SKhatri1029/uwrt_electronics/Maelstrom Boards/Battery Balancer/BatteryBalancer.brd

## EAGLE design Maelstrom Boards/Battery Balancer/BatteryBalancer.brd (2019-02-17)

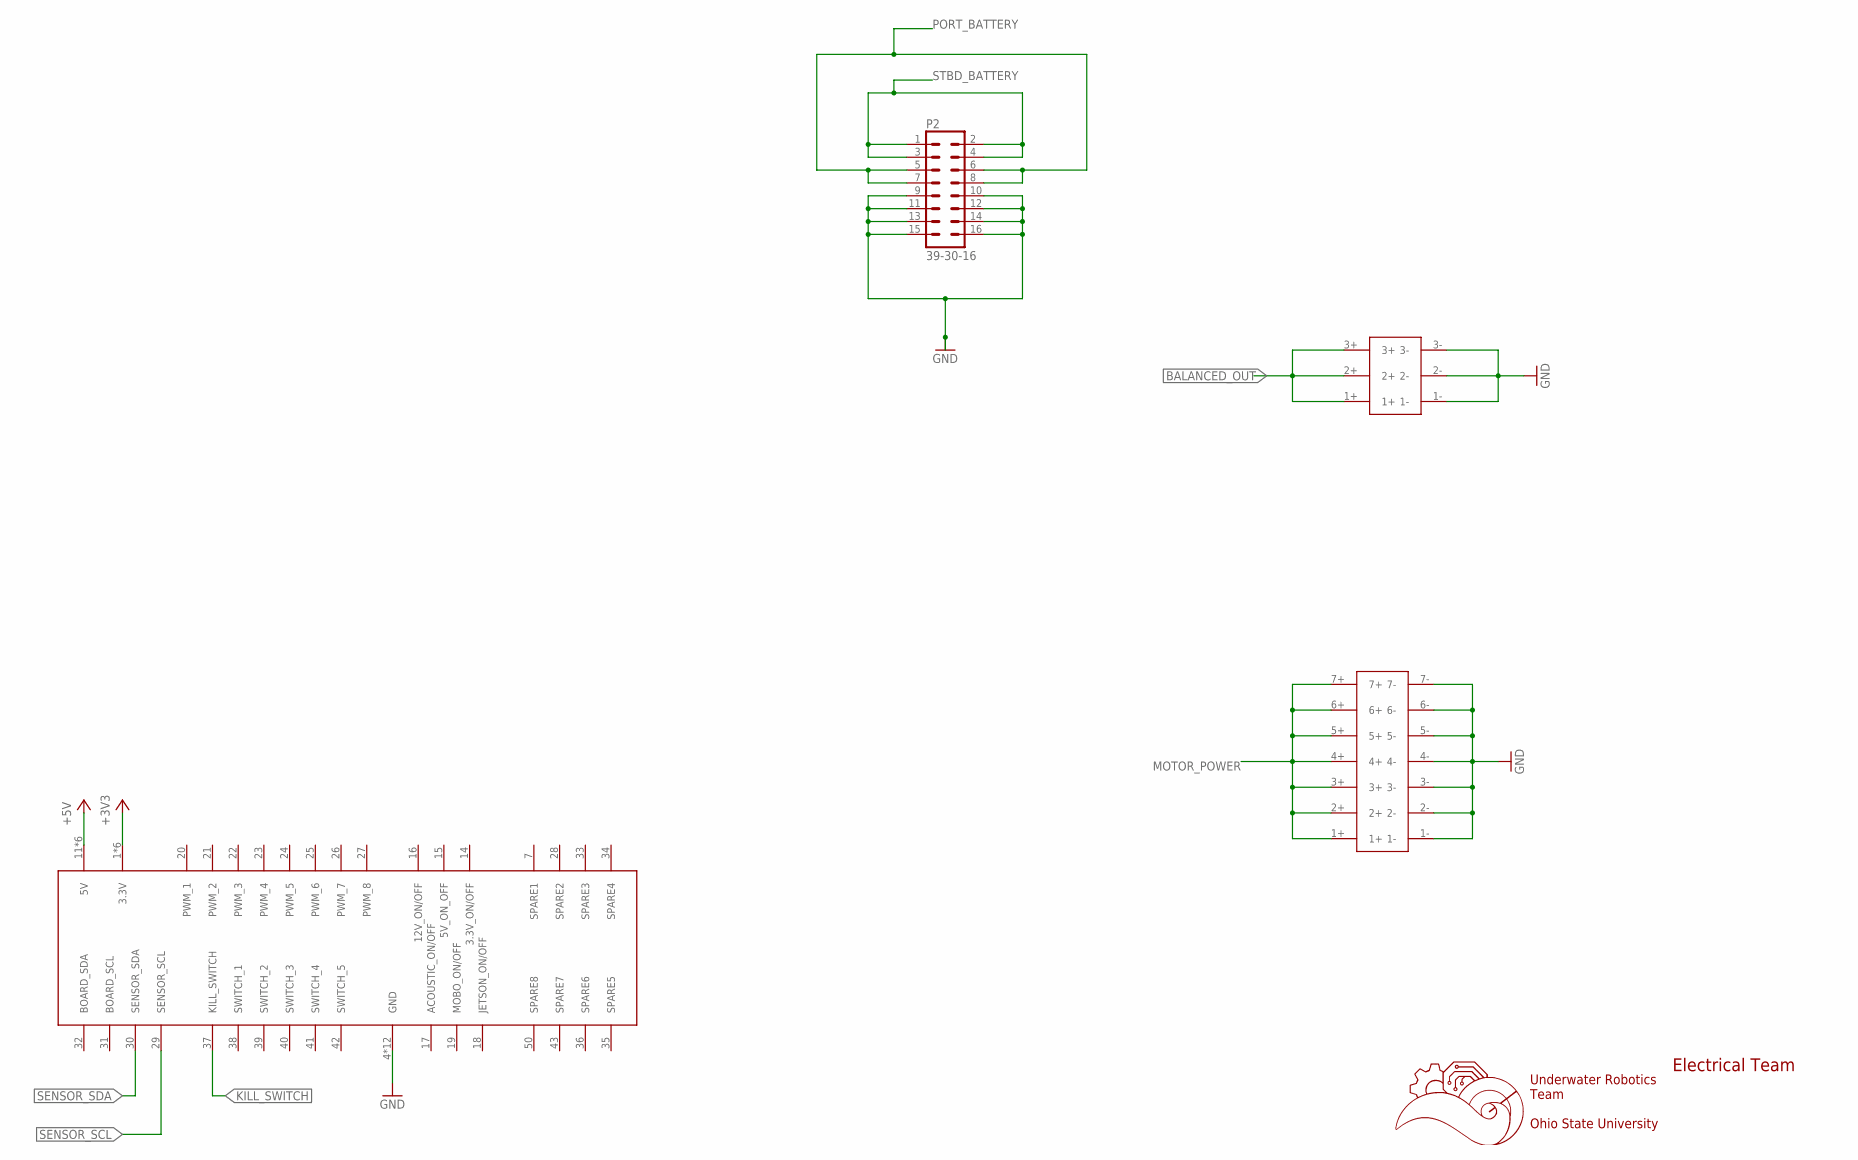
[picture p1: schematic BatteryBalancer.sch, sheet 1, Connectors]

Parts:
P2: 39-30-16; 39-30-?16?
U$1: 5530843-EDGE; 5530843-6-BOARDFINGERS
U$4: 14PIN-VERT; 14PIN_VERT
U$13: 6PIN-VERT; 6PIN_VERT

Connections:
+3V3: U$1.1 (3.3V), U$1.2 (3.3V), U$1.3 (3.3V), U$1.54 (3.3V), U$1.55 (3.3V), U$1.56 (3.3V); also elsewhere on the board
+5V: U$1.11 (5V), U$1.12 (5V), U$1.13 (5V), U$1.44 (5V), U$1.45 (5V), U$1.46 (5V)
BALANCED_OUT: U$13.1+, U$13.2+, U$13.3+; also elsewhere on the board
GND: P2.9, P2.10, P2.11, P2.12, P2.13, P2.14, P2.15, P2.16, U$1.4 (GND), U$1.5 (GND), U$1.6 (GND), U$1.8 (GND), U$1.9 (GND), U$1.10 (GND), U$1.47 (GND), U$1.48 (GND), U$1.49 (GND), U$1.51 (GND), U$1.52 (GND), U$1.53 (GND), U$4.1-, U$4.2-, U$4.3-, U$4.4-, U$4.5-, U$4.6-, U$4.7-, U$13.1-, U$13.2-, U$13.3-; also elsewhere on the board
KILL_SWITCH: U$1.37 (KILL_SWITCH); also elsewhere on the board
MOTOR_POWER: U$4.1+, U$4.2+, U$4.3+, U$4.4+, U$4.5+, U$4.6+, U$4.7+; also elsewhere on the board
PORT_BATTERY: P2.5, P2.6, P2.7, P2.8; also elsewhere on the board
SENSOR_SCL: U$1.29 (SENSOR_SCL); also elsewhere on the board
SENSOR_SDA: U$1.30 (SENSOR_SDA); also elsewhere on the board
STBD_BATTERY: P2.1, P2.2, P2.3, P2.4; also elsewhere on the board

Notes on the sheet:
Underwater Robotics Team Ohio State University
Electrical Team

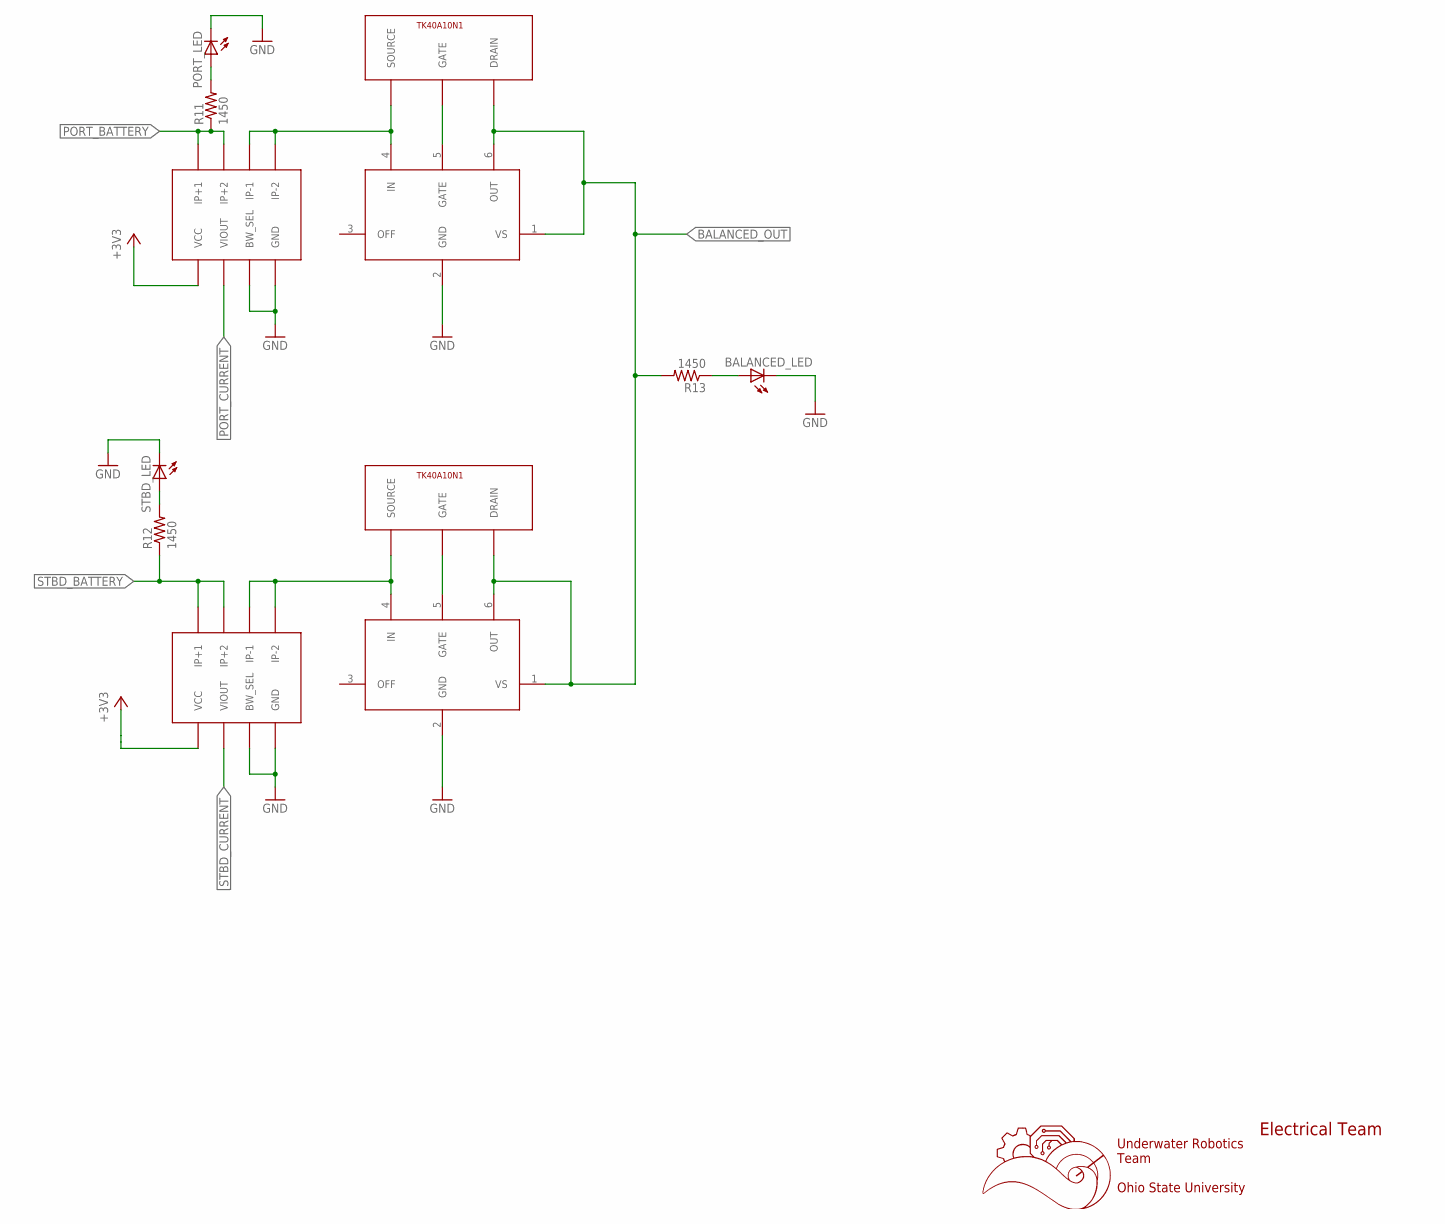
[picture p2: schematic BatteryBalancer.sch, sheet 2]

Parts:
BALANCED_LED: LEDCHIP-LED0603; CHIP-LED0603
PORT_LED: LEDCHIP-LED0603; CHIP-LED0603
R11, R12, R13: 1450; R0603
STBD_LED: LEDCHIP-LED0603; CHIP-LED0603
U$2, U$3: LM5050
U$5, U$15: IXFX64N60P3TK40A10N1; IXFX64N60P3
U$6, U$7: ACS722; SOIC-8

Connections:
+3V3: U$6.VCC, U$7.VCC; also elsewhere on the board
BALANCED_OUT: R13.2, U$2.1 (VS), U$2.6 (OUT), U$3.1 (VS), U$3.6 (OUT), U$5.DRAIN, U$15.DRAIN; also elsewhere on the board
GND: BALANCED_LED.C, PORT_LED.C, STBD_LED.C, U$2.2 (GND), U$3.2 (GND), U$6.BW_SEL, U$6.GND, U$7.BW_SEL, U$7.GND; also elsewhere on the board
unnamed: U$2.4 (IN), U$6.IP-1, U$6.IP-2, U$15.SOURCE
unnamed: U$2.5 (GATE), U$15.GATE
unnamed: U$3.5 (GATE), U$5.GATE
unnamed: PORT_LED.A, R11.2
unnamed: R12.2, STBD_LED.A
unnamed: BALANCED_LED.A, R13.1
PORT_BATTERY: R11.1, U$6.IP+1, U$6.IP+2; also elsewhere on the board
PORT_CURRENT: U$6.VIOUT; also elsewhere on the board
SOURCE: U$3.4 (IN), U$5.SOURCE, U$7.IP-1, U$7.IP-2
STBD_BATTERY: R12.1, U$7.IP+1, U$7.IP+2; also elsewhere on the board
STBD_CURRENT: U$7.VIOUT; also elsewhere on the board

Notes on the sheet:
Underwater Robotics Team Ohio State University
Electrical Team

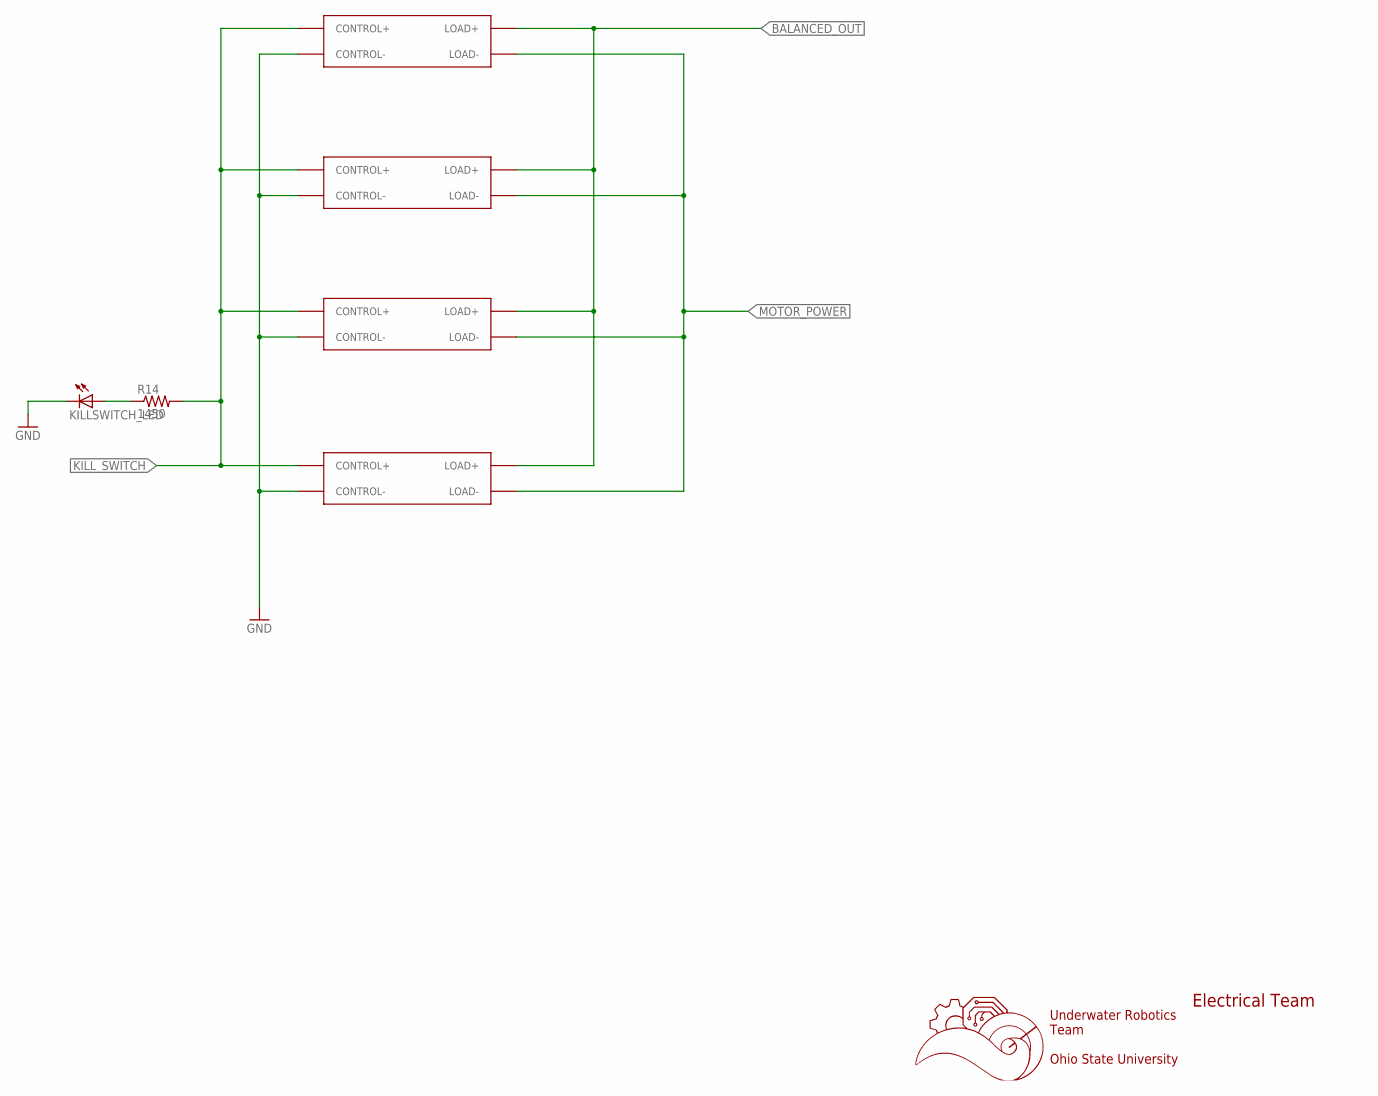
[picture p3: schematic BatteryBalancer.sch, sheet 3, Relays]

Parts:
KILLSWITCH_LED: LEDCHIP-LED0603; CHIP-LED0603
R14: 1450; R0603
U$8, U$9, U$10, U$11: CMX60D20

Connections:
BALANCED_OUT: U$8.LOAD+, U$9.LOAD+, U$10.LOAD+, U$11.LOAD+; also elsewhere on the board
GND: KILLSWITCH_LED.C, U$8.CONTROL-, U$9.CONTROL-, U$10.CONTROL-, U$11.CONTROL-; also elsewhere on the board
KILL_SWITCH: R14.2, U$8.CONTROL+, U$9.CONTROL+, U$10.CONTROL+, U$11.CONTROL+; also elsewhere on the board
MOTOR_POWER: U$8.LOAD-, U$9.LOAD-, U$10.LOAD-, U$11.LOAD-; also elsewhere on the board
unnamed: KILLSWITCH_LED.A, R14.1

Notes on the sheet:
Underwater Robotics Team Ohio State University
Electrical Team

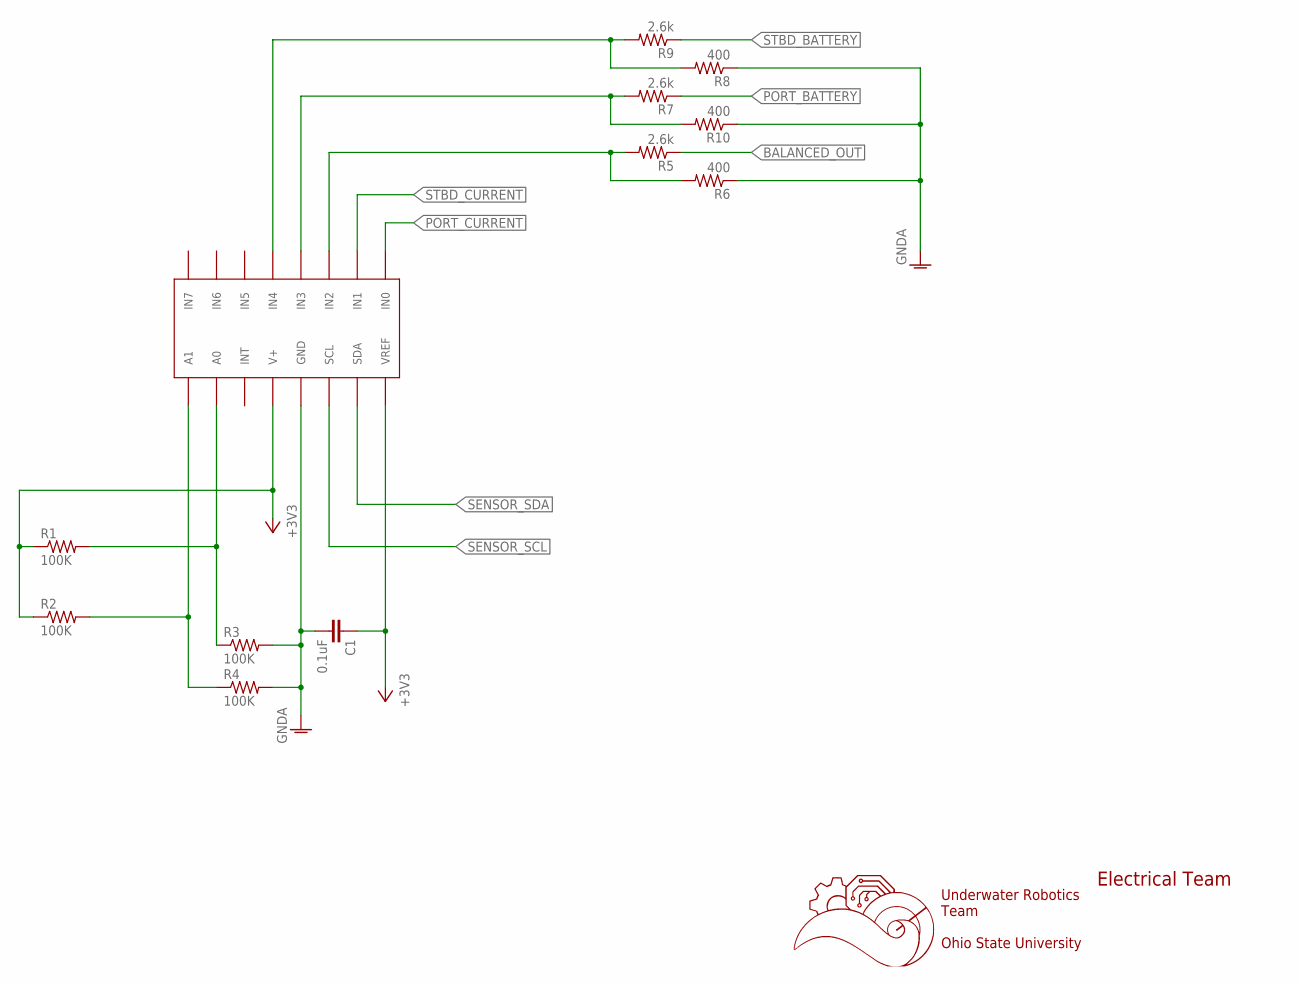
[picture p4: schematic BatteryBalancer.sch, sheet 4, ADC]

Parts:
C1: 0.1uF; C0603
R1, R2, R3, R4: 100K; R0603
R5, R7, R9: 2.6k; R0603
R6, R8, R10: 400; R0603
U$12: ADC128D818; TSSOP-16

Connections:
+3V3: C1.1, U$12.VREF; also elsewhere on the board
BALANCED_OUT: R5.1; also elsewhere on the board
GNDA: C1.2, R3.2, R4.2, R6.1, R8.1, R10.1, U$12.GND
unnamed: R2.2, R4.1, U$12.A1
unnamed: R1.2, R3.1, U$12.A0
unnamed: R1.1, R2.1, U$12.V+
unnamed: R7.2, R10.2, U$12.IN3
unnamed: R8.2, R9.2, U$12.IN4
unnamed: R5.2, R6.2, U$12.IN2
PORT_BATTERY: R7.1; also elsewhere on the board
PORT_CURRENT: U$12.IN0; also elsewhere on the board
SENSOR_SCL: U$12.SCL; also elsewhere on the board
SENSOR_SDA: U$12.SDA; also elsewhere on the board
STBD_BATTERY: R9.1; also elsewhere on the board
STBD_CURRENT: U$12.IN1; also elsewhere on the board

Notes on the sheet:
Underwater Robotics Team Ohio State University
Electrical Team

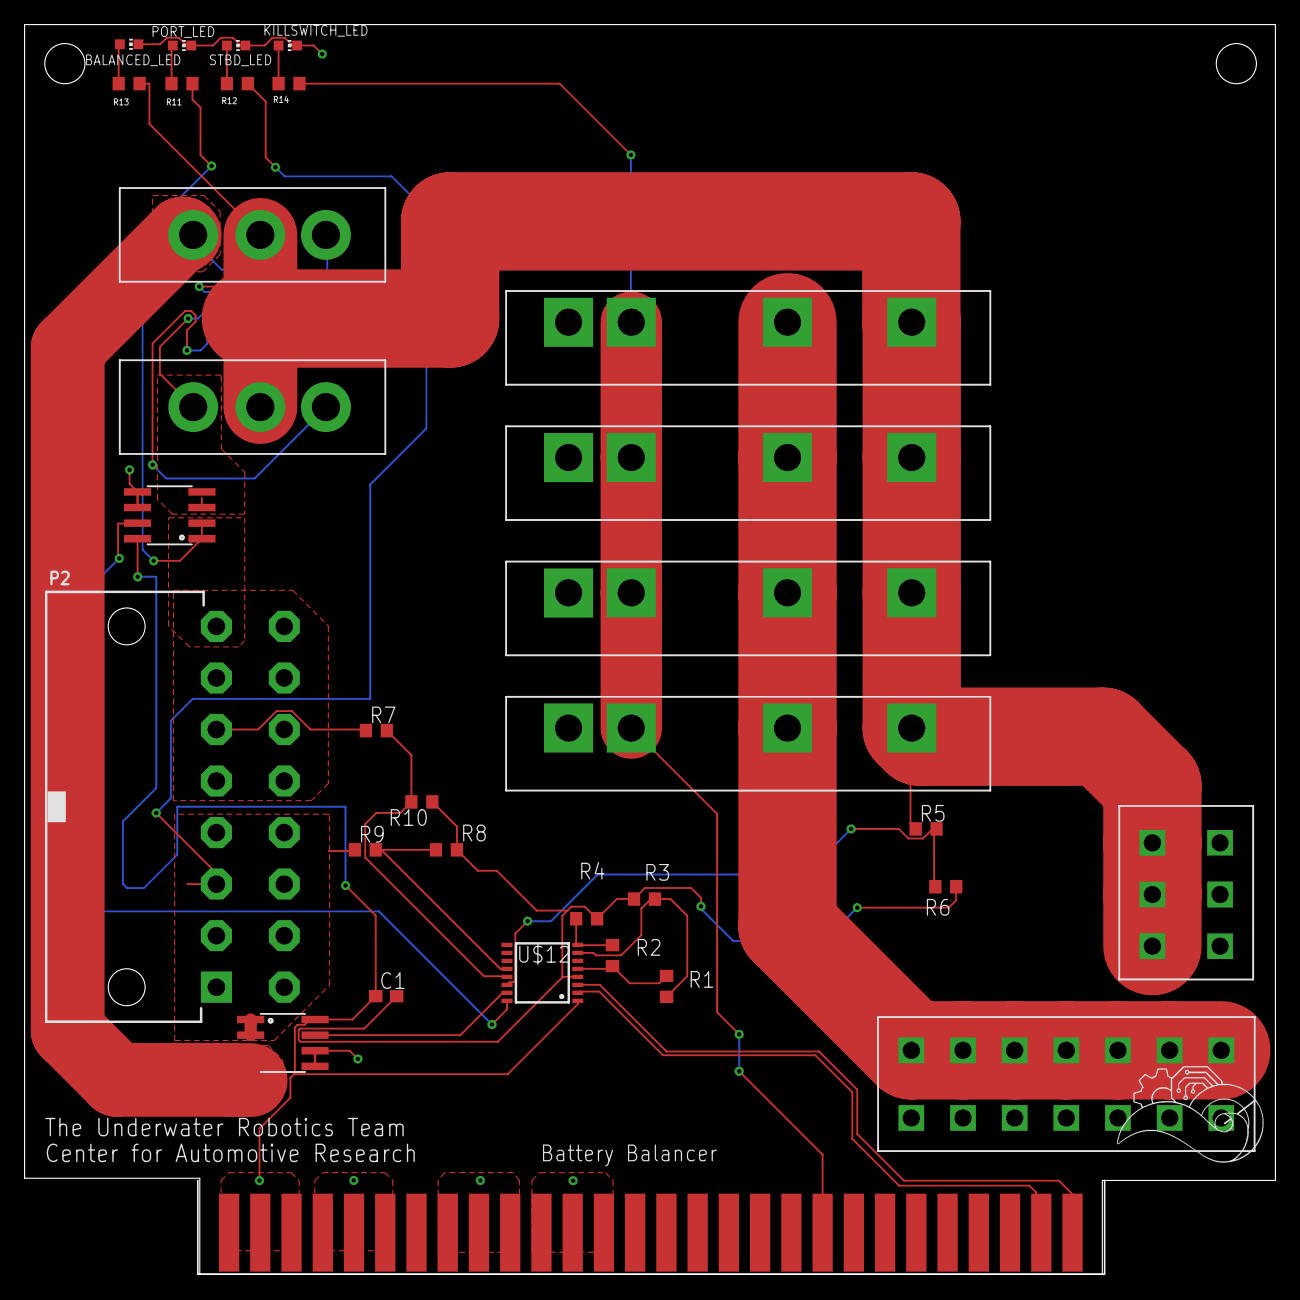
[picture p5: board BatteryBalancer.brd from above]

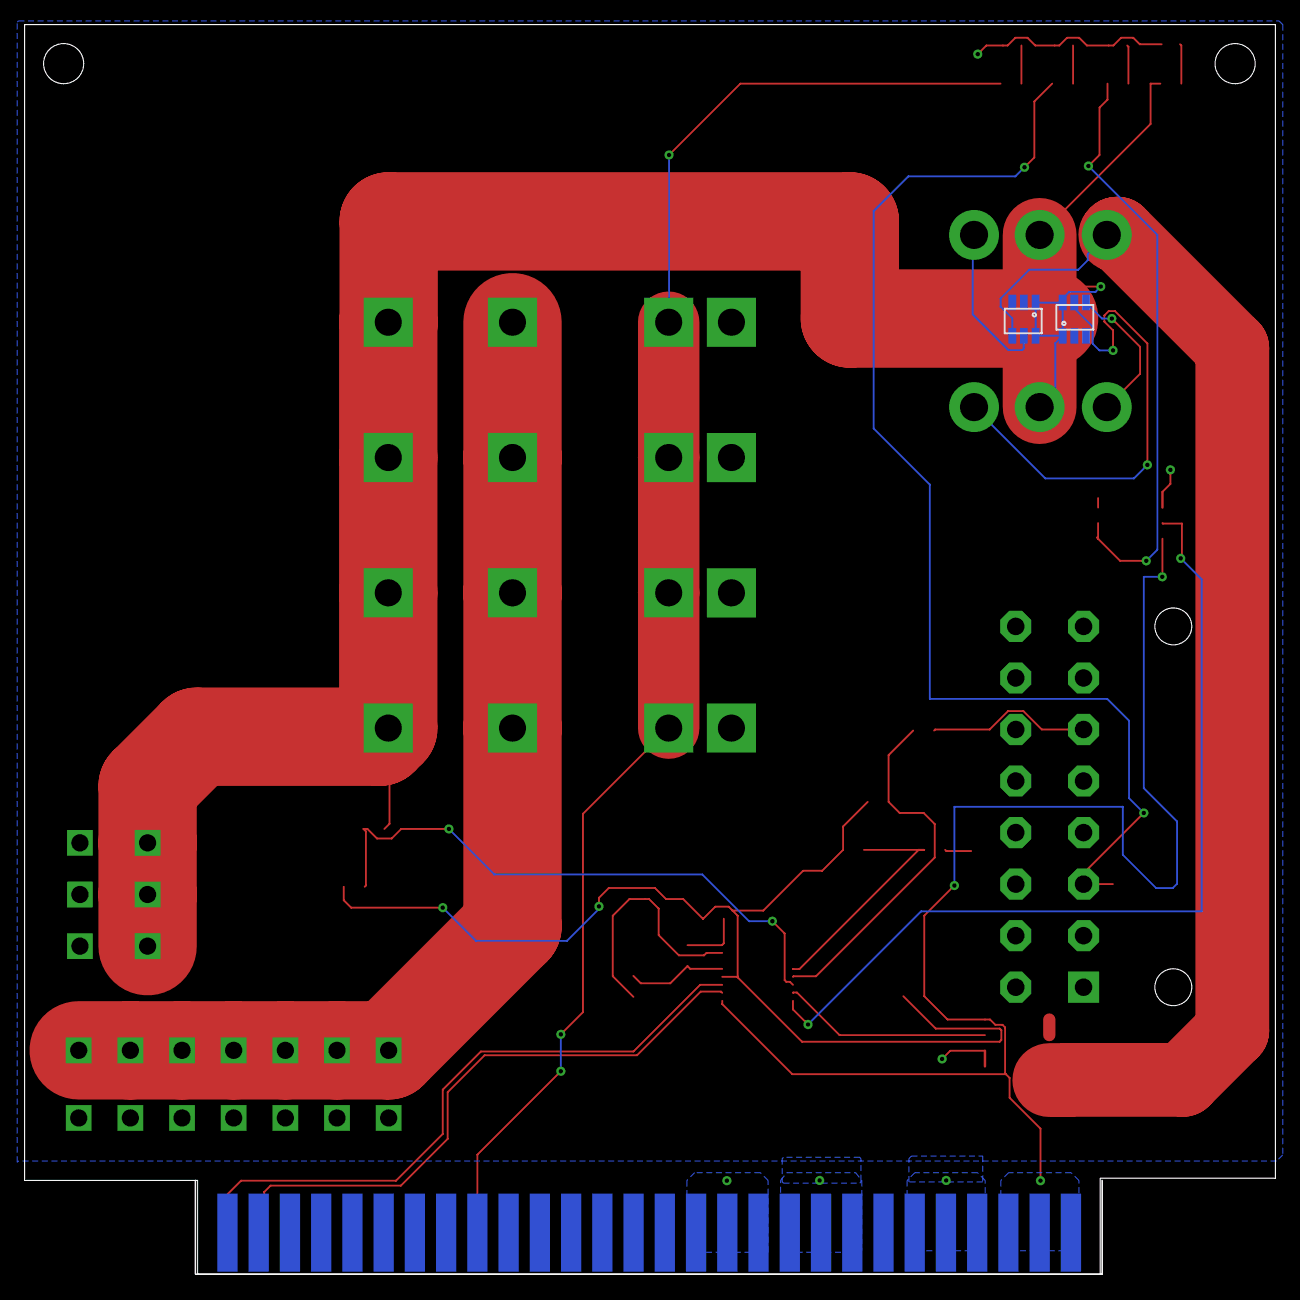
[picture p6: board BatteryBalancer.brd from below]

Board: 2 copper layers, 101.7 x 101.6 mm, 34 parts (2 on the bottom side), 27 nets.
