SKhatri1029/uwrt_electronics/Maelstrom Boards/Backplane/Backplane.brd

## EAGLE design Maelstrom Boards/Backplane/Backplane.brd (2019-02-17)

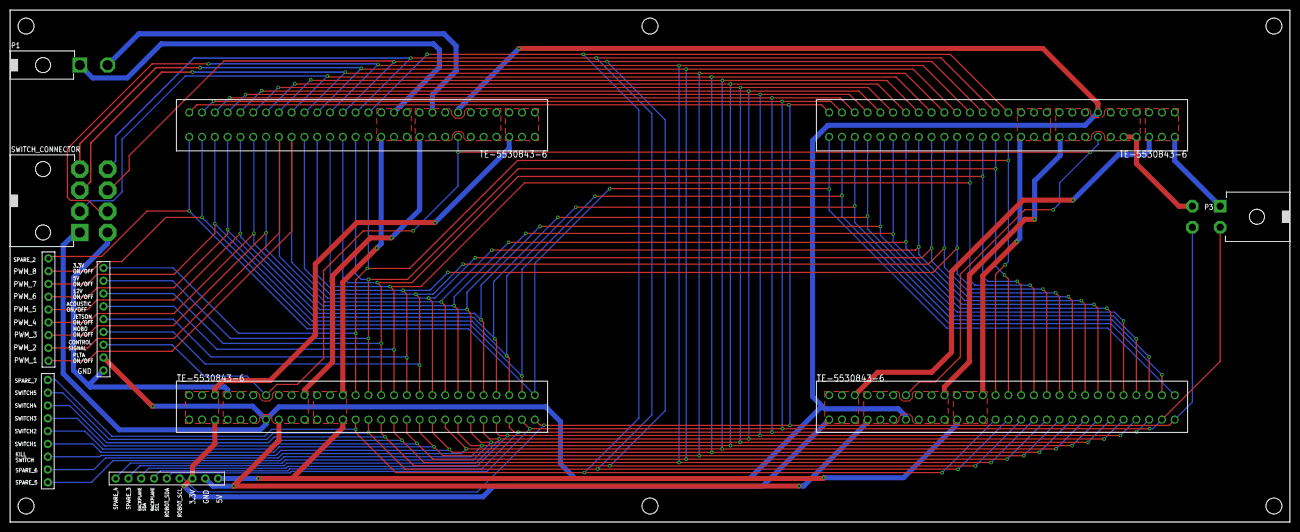
[picture p7: board Backplane.brd from above]

Board: 2 copper layers, 254.0 x 101.6 mm, 11 parts (0 on the bottom side), 35 nets.

Parts:
P1: 39-30-02?_S; 39-30-?02?
P3: 39-30-04?_S; 39-30-?04?
SWITCH_CONNECTOR: 39-30-08?_S; 39-30-?08?
U$1, U$2, U$3, U$4: 5530843-FEMALE; 5530843-6-BACKPLANEMATE
U$5: 929870-01-09_1; 929852-01-09_1ROW
U$6: 929870-01-09_2; 929852-01-09_1ROW
U$7: 929870-01-09_3; 929852-01-09_1ROW
U$8: 929870-01-09_4; 929852-01-09_1ROW

Connections:
3.3V: P3.1, U$1.1, U$1.2, U$1.3, U$1.54, U$1.55, U$1.56, U$2.1, U$2.2, U$2.3, U$2.54, U$2.55, U$2.56, U$3.1, U$3.2, U$3.3, U$3.54, U$3.55, U$3.56, U$4.1, U$4.2, U$4.3, U$4.54, U$4.55, U$4.56, U$8.P$7
3.3V_ON/OFF: U$1.14, U$2.14, U$3.14, U$4.14, U$7.P$1
5V: P1.1, U$1.11, U$1.12, U$1.13, U$1.44, U$1.45, U$1.46, U$2.11, U$2.12, U$2.13, U$2.44, U$2.45, U$2.46, U$3.11, U$3.12, U$3.13, U$3.44, U$3.45, U$3.46, U$4.11, U$4.12, U$4.13, U$4.44, U$4.45, U$4.46, U$8.P$9
5V_ON/OFF: U$1.15, U$2.15, U$3.15, U$4.15, U$7.P$2
12V_ON/OFF: U$1.16, U$2.16, U$3.16, U$4.16, U$7.P$3
ACOUSTIC_ON/OFF: U$1.17, U$2.17, U$3.17, U$4.17, U$7.P$4
BACKPLANE_SCL: U$1.31, U$2.31, U$3.31, U$4.31, U$8.P$4
BACKPLANE_SDA: U$1.32, U$2.32, U$3.32, U$4.32, U$8.P$3
CONTROL_SIGNAL: U$1.7, U$2.7, U$3.7, U$4.7, U$7.P$7
GND: P1.2, P3.3, SWITCH_CONNECTOR.5, U$1.4, U$1.5, U$1.6, U$1.8, U$1.9, U$1.10, U$1.47, U$1.48, U$1.49, U$1.51, U$1.52, U$1.53, U$2.4, U$2.5, U$2.6, U$2.8, U$2.9, U$2.10, U$2.47, U$2.48, U$2.49, U$2.51, U$2.52, U$2.53, U$3.4, U$3.5, U$3.6, U$3.8, U$3.9, U$3.10, U$3.47, U$3.48, U$3.49, U$3.51, U$3.52, U$3.53, U$4.4, U$4.5, U$4.6, U$4.8, U$4.9, U$4.10, U$4.47, U$4.48, U$4.49, U$4.51, U$4.52, U$4.53, U$7.P$9, U$8.P$8
JETSON_ON/OFF: U$1.18, U$2.18, U$3.18, U$4.18, U$7.P$5
KILL_SWITCH: SWITCH_CONNECTOR.2, U$1.37, U$2.37, U$3.37, U$4.37, U$5.P$7
MOBO_ON/OFF: U$1.19, U$2.19, U$3.19, U$4.19, U$7.P$6
PLTA_ON/OFF: SWITCH_CONNECTOR.1, U$1.50, U$2.50, U$3.50, U$4.50, U$7.P$8
PWM_1: U$1.20, U$2.20, U$3.20, U$4.20, U$6.P$9
PWM_2: U$1.21, U$2.21, U$3.21, U$4.21, U$6.P$8
PWM_3: U$1.22, U$2.22, U$3.22, U$4.22, U$6.P$7
PWM_4: U$1.23, U$2.23, U$3.23, U$4.23, U$6.P$6
PWM_5: U$1.24, U$2.24, U$3.24, U$4.24, U$6.P$5
PWM_6: U$1.25, U$2.25, U$3.25, U$4.25, U$6.P$4
PWM_7: U$1.26, U$2.26, U$3.26, U$4.26, U$6.P$3
PWM_8: U$1.27, U$2.27, U$3.27, U$4.27, U$6.P$2
ROBOT_SCL: P3.4, U$1.29, U$2.29, U$3.29, U$4.29, U$8.P$6
ROBOT_SDA: P3.2, U$1.30, U$2.30, U$3.30, U$4.30, U$8.P$5
SPARE2: U$1.28, U$2.28, U$3.28, U$4.28, U$6.P$1
SPARE3: U$1.33, U$2.33, U$3.33, U$4.33, U$8.P$2
SPARE4: U$1.34, U$2.34, U$3.34, U$4.34, U$8.P$1
SPARE5: U$1.35, U$2.35, U$3.35, U$4.35, U$5.P$9
SPARE6: U$1.36, U$2.36, U$3.36, U$4.36, U$5.P$8
SPARE7: U$1.43, U$2.43, U$3.43, U$4.43, U$5.P$1
SWITCH_1: SWITCH_CONNECTOR.3, U$1.38, U$2.38, U$3.38, U$4.38, U$5.P$6
SWITCH_2: SWITCH_CONNECTOR.4, U$1.39, U$2.39, U$3.39, U$4.39, U$5.P$5
SWITCH_3: SWITCH_CONNECTOR.6, U$1.40, U$2.40, U$3.40, U$4.40, U$5.P$4
SWITCH_4: SWITCH_CONNECTOR.7, U$1.41, U$2.41, U$3.41, U$4.41, U$5.P$3
SWITCH_5: SWITCH_CONNECTOR.8, U$1.42, U$2.42, U$3.42, U$4.42, U$5.P$2
