SKhatri1029/uwrt_electronics/Maelstrom Boards/Status Board/Status Board.brd

## EAGLE design Maelstrom Boards/Status Board/Status Board.brd (2019-02-17)

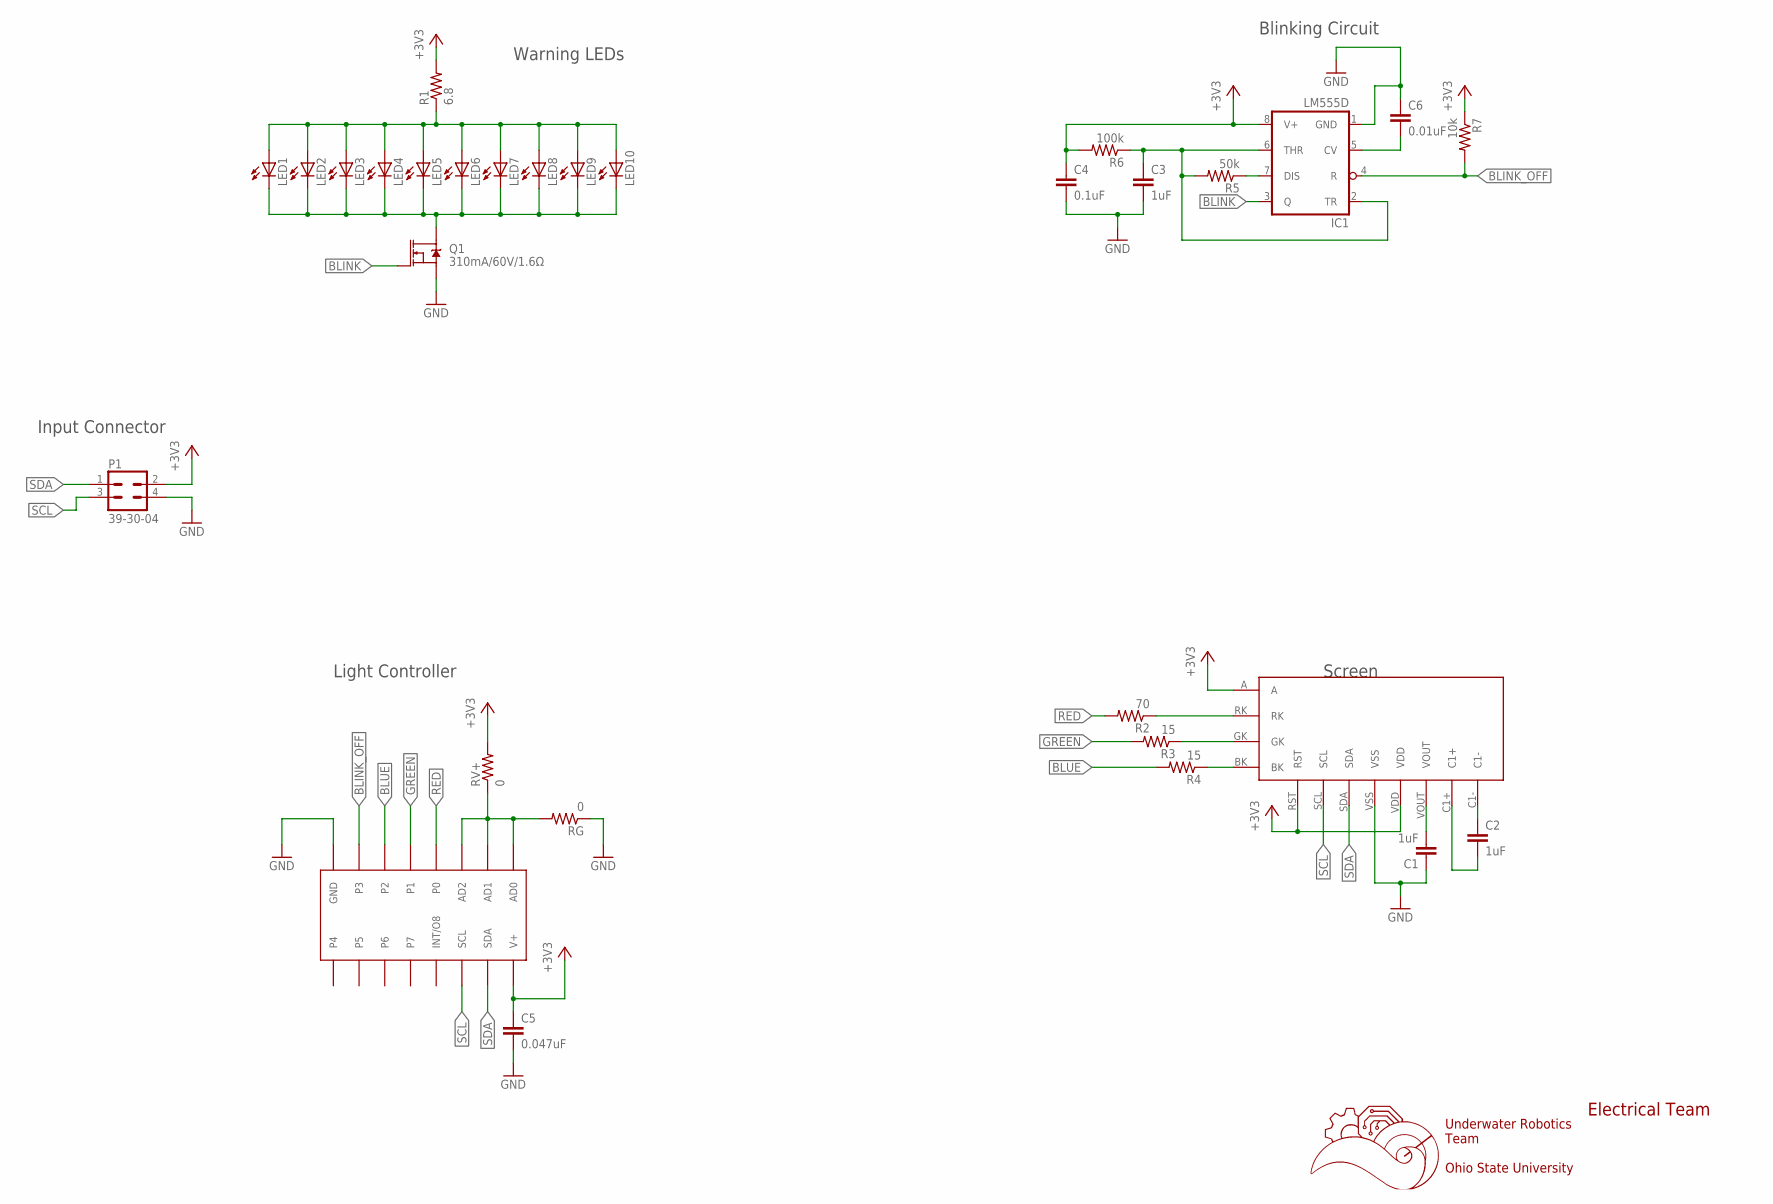
[picture p8: schematic Status Board.sch, Connectors]

Parts:
C1, C2, C3: 1uF; C0603
C4: 0.1uF; C0603
C5: 0.047uF; C0603
C6: 0.01uF; C0603
IC1: LM555D; SO08
LED1, LED2, LED3, LED4, LED5, LED6, LED7, LED8, LED9, LED10: LEDCHIPLED_0603; CHIPLED_0603
P1: 39-30-04; 39-30-?04?
Q1: 310mA/60V/1.6Ω; SOT323
R1: 6.8; R0603
R2: 70; R0603
R3, R4: 15; R0603
R5: 50k; R0603
R6: 100k; R0603
R7: 10k; R0603
RG: 0; R0603
RV+: 0; R0603
U$1: NHD-C0220BIZ
U$2: MAX7315; TSSOP-16

Connections:
+3V3: C4.1, C5.1, IC1.8 (V+), P1.2, R1.2, R6.2, R7.1, RV+.2, U$1.A, U$1.RST, U$1.VDD, U$2.16 (V+)
BLINK: IC1.3 (Q), Q1.1 (G)
BLINK_OFF: IC1.4 (R), R7.2, U$2.7 (P3)
BLUE: R4.2, U$2.6 (P2)
GND: C1.1, C3.2, C4.2, C5.2, C6.1, IC1.1 (GND), P1.4, Q1.2 (S), RG.1, U$1.VSS, U$2.8 (GND)
GREEN: R3.2, U$2.5 (P1)
unnamed: R3.1, U$1.GK
unnamed: C2.1, U$1.C1-
unnamed: C1.2, U$1.VOUT
unnamed: C2.2, U$1.C1+
unnamed: R4.1, U$1.BK
unnamed: RG.2, RV+.1, U$2.1 (AD0), U$2.2 (AD1), U$2.3 (AD2)
unnamed: R2.1, U$1.RK
unnamed: C6.2, IC1.5 (CV)
unnamed: IC1.7 (DIS), R5.1
unnamed: C3.1, IC1.2 (TR), IC1.6 (THR), R5.2, R6.1
unnamed: LED1.A, LED2.A, LED3.A, LED4.A, LED5.A, LED6.A, LED7.A, LED8.A, LED9.A, LED10.A, R1.1
unnamed: LED1.C, LED2.C, LED3.C, LED4.C, LED5.C, LED6.C, LED7.C, LED8.C, LED9.C, LED10.C, Q1.3 (D)
RED: R2.2, U$2.4 (P0)
SCL: P1.3, U$1.SCL, U$2.14 (SCL)
SDA: P1.1, U$1.SDA, U$2.15 (SDA)

Notes on the sheet:
Underwater Robotics Team Ohio State University
Electrical Team
Warning LEDs
Blinking Circuit
Screen
Light Controller
Input Connector

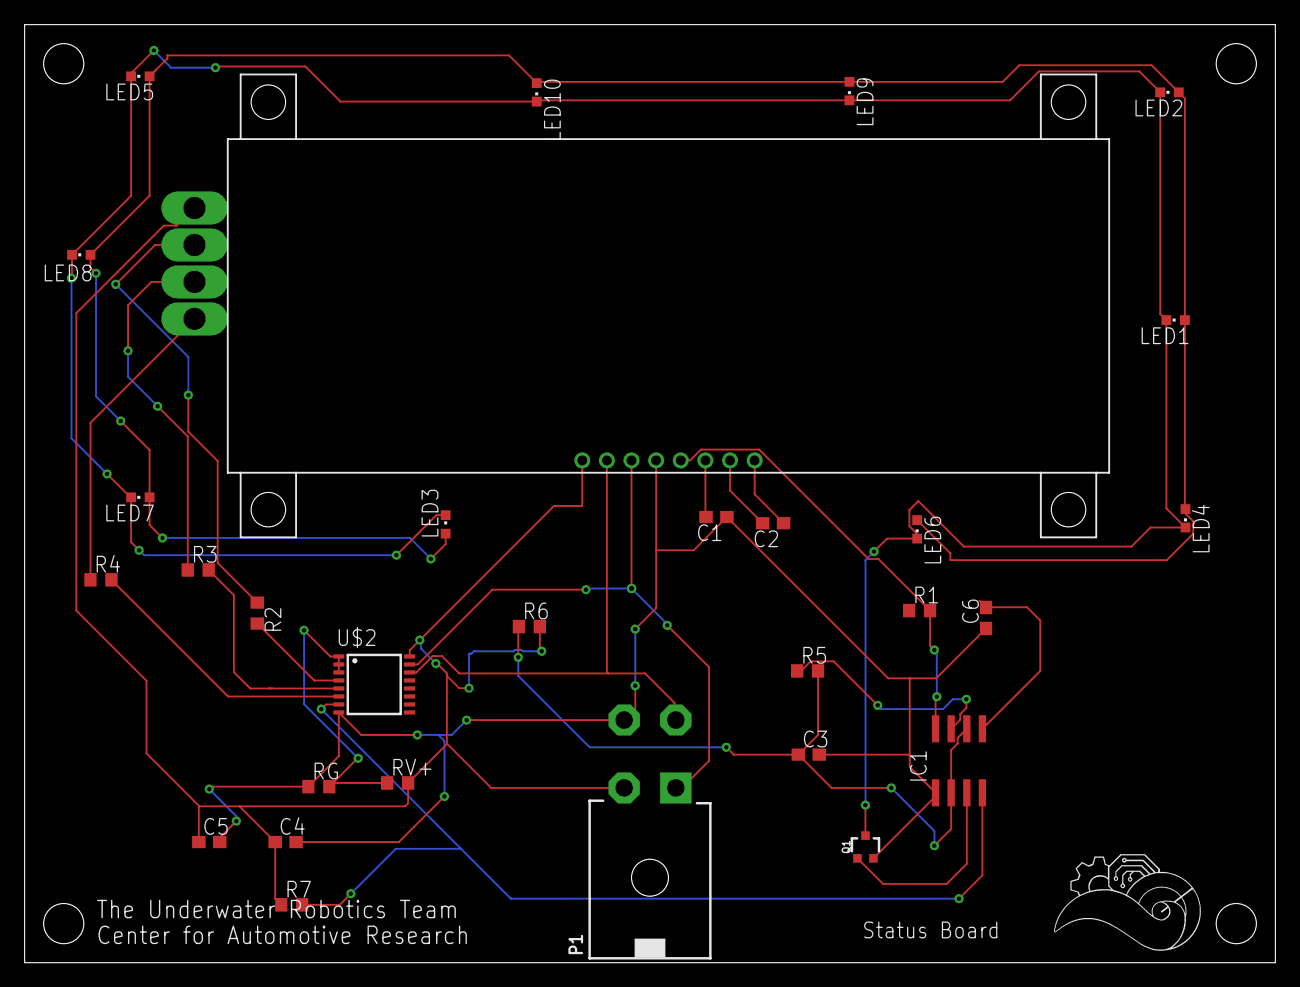
[picture p9: board Status Board.brd from above]

Board: 2 copper layers, 101.6 x 76.2 mm, 30 parts (0 on the bottom side), 21 nets.
