SKhatri1029/uwrt_electronics/Maelstrom Boards/CoProcessor/CoProcessor.brd

## EAGLE design Maelstrom Boards/CoProcessor/CoProcessor.brd (2019-02-17)

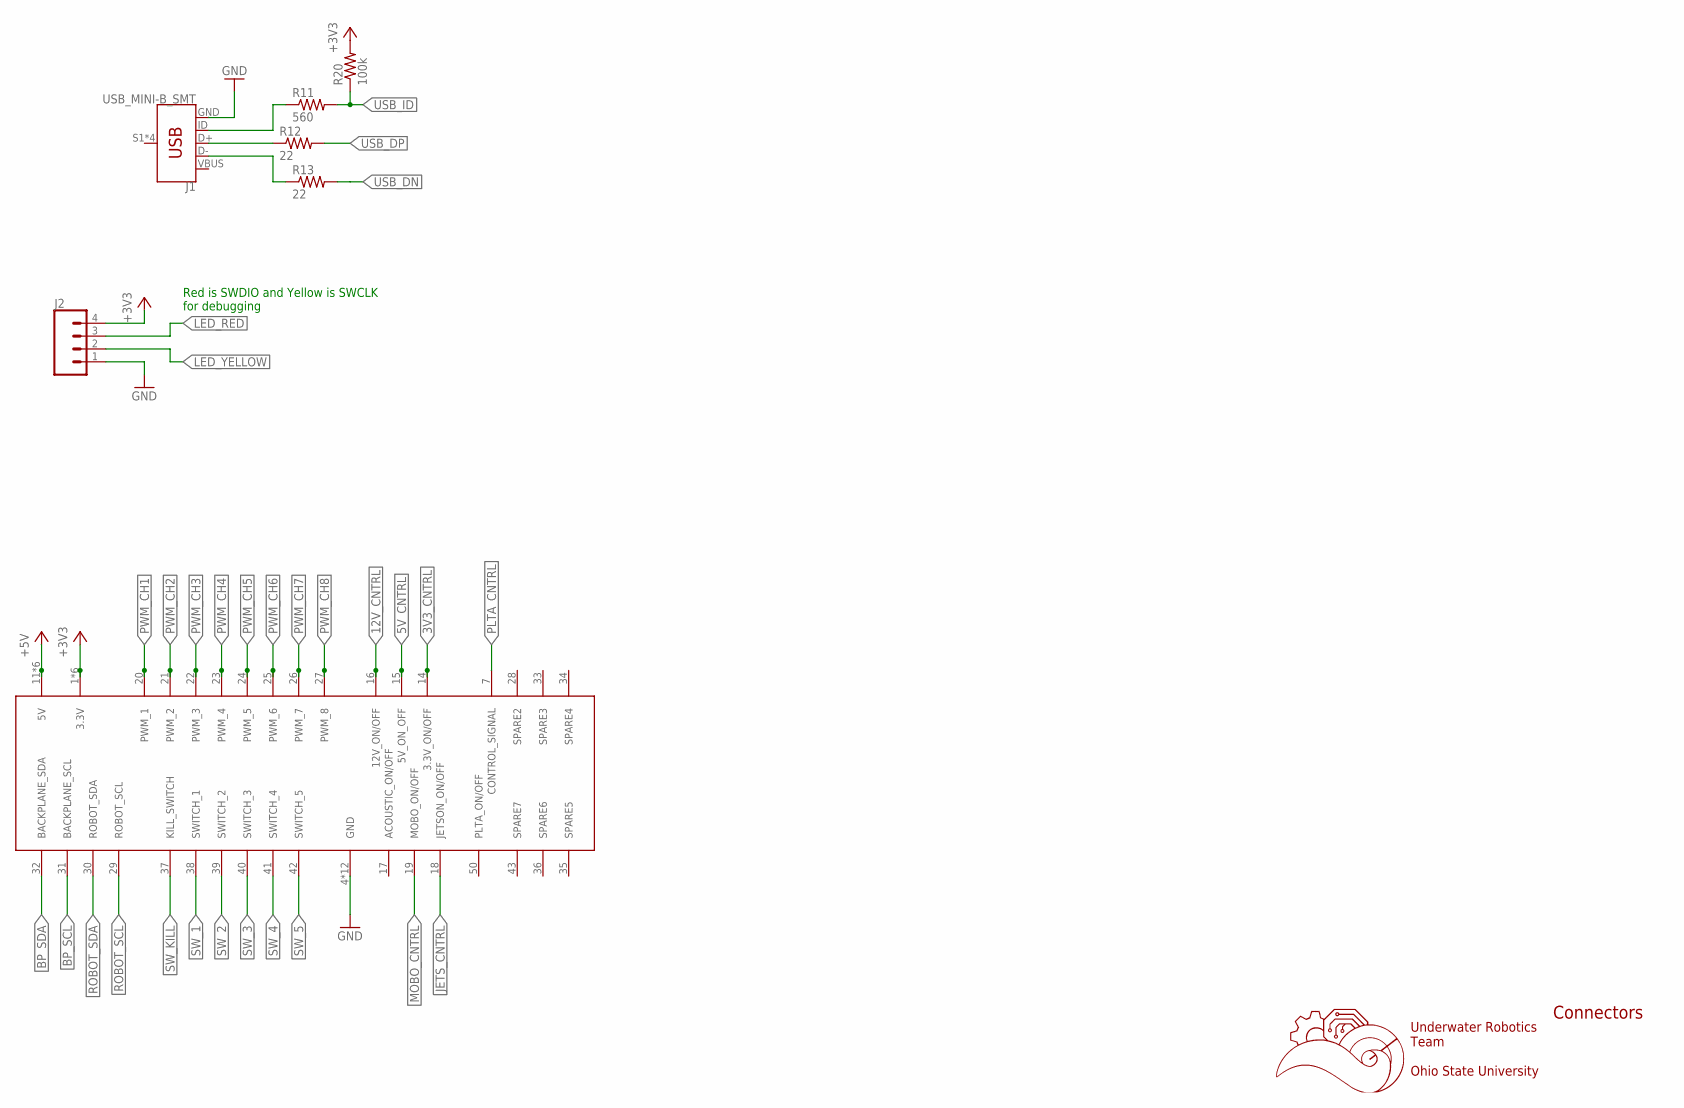
[picture p10: schematic CoProcessor.sch, sheet 1, Connectors]

Parts:
J1: USB_MINI-B_SMT; USB-MINIB
J2: CONN_04; 1X04
R11: 560; R0603
R12, R13: 22; R0603
R20: 100k; R0603
U$1: 5530843-EDGE; 5530843-6-BOARDFINGERS

Connections:
3V3_CNTRL: U$1.14 (3.3V_ON/OFF); also elsewhere on the board
5V_CNTRL: U$1.15 (5V_ON_OFF); also elsewhere on the board
12V_CNTRL: U$1.16 (12V_ON/OFF); also elsewhere on the board
+3V3: J2.4, R20.2, U$1.1 (3.3V), U$1.2 (3.3V), U$1.3 (3.3V), U$1.54 (3.3V), U$1.55 (3.3V), U$1.56 (3.3V); also elsewhere on the board
+5V: U$1.11 (5V), U$1.12 (5V), U$1.13 (5V), U$1.44 (5V), U$1.45 (5V), U$1.46 (5V); also elsewhere on the board
BP_SCL: U$1.31 (BACKPLANE_SCL); also elsewhere on the board
BP_SDA: U$1.32 (BACKPLANE_SDA); also elsewhere on the board
GND: J1.GND, J2.1, U$1.4 (GND), U$1.5 (GND), U$1.6 (GND), U$1.8 (GND), U$1.9 (GND), U$1.10 (GND), U$1.47 (GND), U$1.48 (GND), U$1.49 (GND), U$1.51 (GND), U$1.52 (GND), U$1.53 (GND); also elsewhere on the board
JETS_CNTRL: U$1.18 (JETSON_ON/OFF); also elsewhere on the board
LED_RED: J2.3; also elsewhere on the board
LED_YELLOW: J2.2; also elsewhere on the board
MOBO_CNTRL: U$1.19 (MOBO_ON/OFF); also elsewhere on the board
unnamed: J1.ID, R11.1
unnamed: J1.D+, R12.1
unnamed: J1.D-, R13.1
PLTA_CNTRL: U$1.7 (CONTROL_SIGNAL); also elsewhere on the board
PWM_CH1: U$1.20 (PWM_1); also elsewhere on the board
PWM_CH2: U$1.21 (PWM_2); also elsewhere on the board
PWM_CH3: U$1.22 (PWM_3); also elsewhere on the board
PWM_CH4: U$1.23 (PWM_4); also elsewhere on the board
PWM_CH5: U$1.24 (PWM_5); also elsewhere on the board
PWM_CH6: U$1.25 (PWM_6); also elsewhere on the board
PWM_CH7: U$1.26 (PWM_7); also elsewhere on the board
PWM_CH8: U$1.27 (PWM_8); also elsewhere on the board
ROBOT_SCL: U$1.29 (ROBOT_SCL); also elsewhere on the board
ROBOT_SDA: U$1.30 (ROBOT_SDA); also elsewhere on the board
SW_1: U$1.38 (SWITCH_1); also elsewhere on the board
SW_2: U$1.39 (SWITCH_2); also elsewhere on the board
SW_3: U$1.40 (SWITCH_3); also elsewhere on the board
SW_4: U$1.41 (SWITCH_4); also elsewhere on the board
SW_5: U$1.42 (SWITCH_5); also elsewhere on the board
SW_KILL: U$1.37 (KILL_SWITCH); also elsewhere on the board
USB_DN: R13.2; also elsewhere on the board
USB_DP: R12.2; also elsewhere on the board
USB_ID: R11.2, R20.1
VBUS: J1.VBUS

Notes on the sheet:
Underwater Robotics Team Ohio State University
Connectors
Red is SWDIO and Yellow is SWCLK for debugging
