SKhatri1029/uwrt_electronics/Maelstrom Boards/CoProcessor/CoProcessor.brd

## EAGLE design Maelstrom Boards/CoProcessor/CoProcessor.brd (continued)

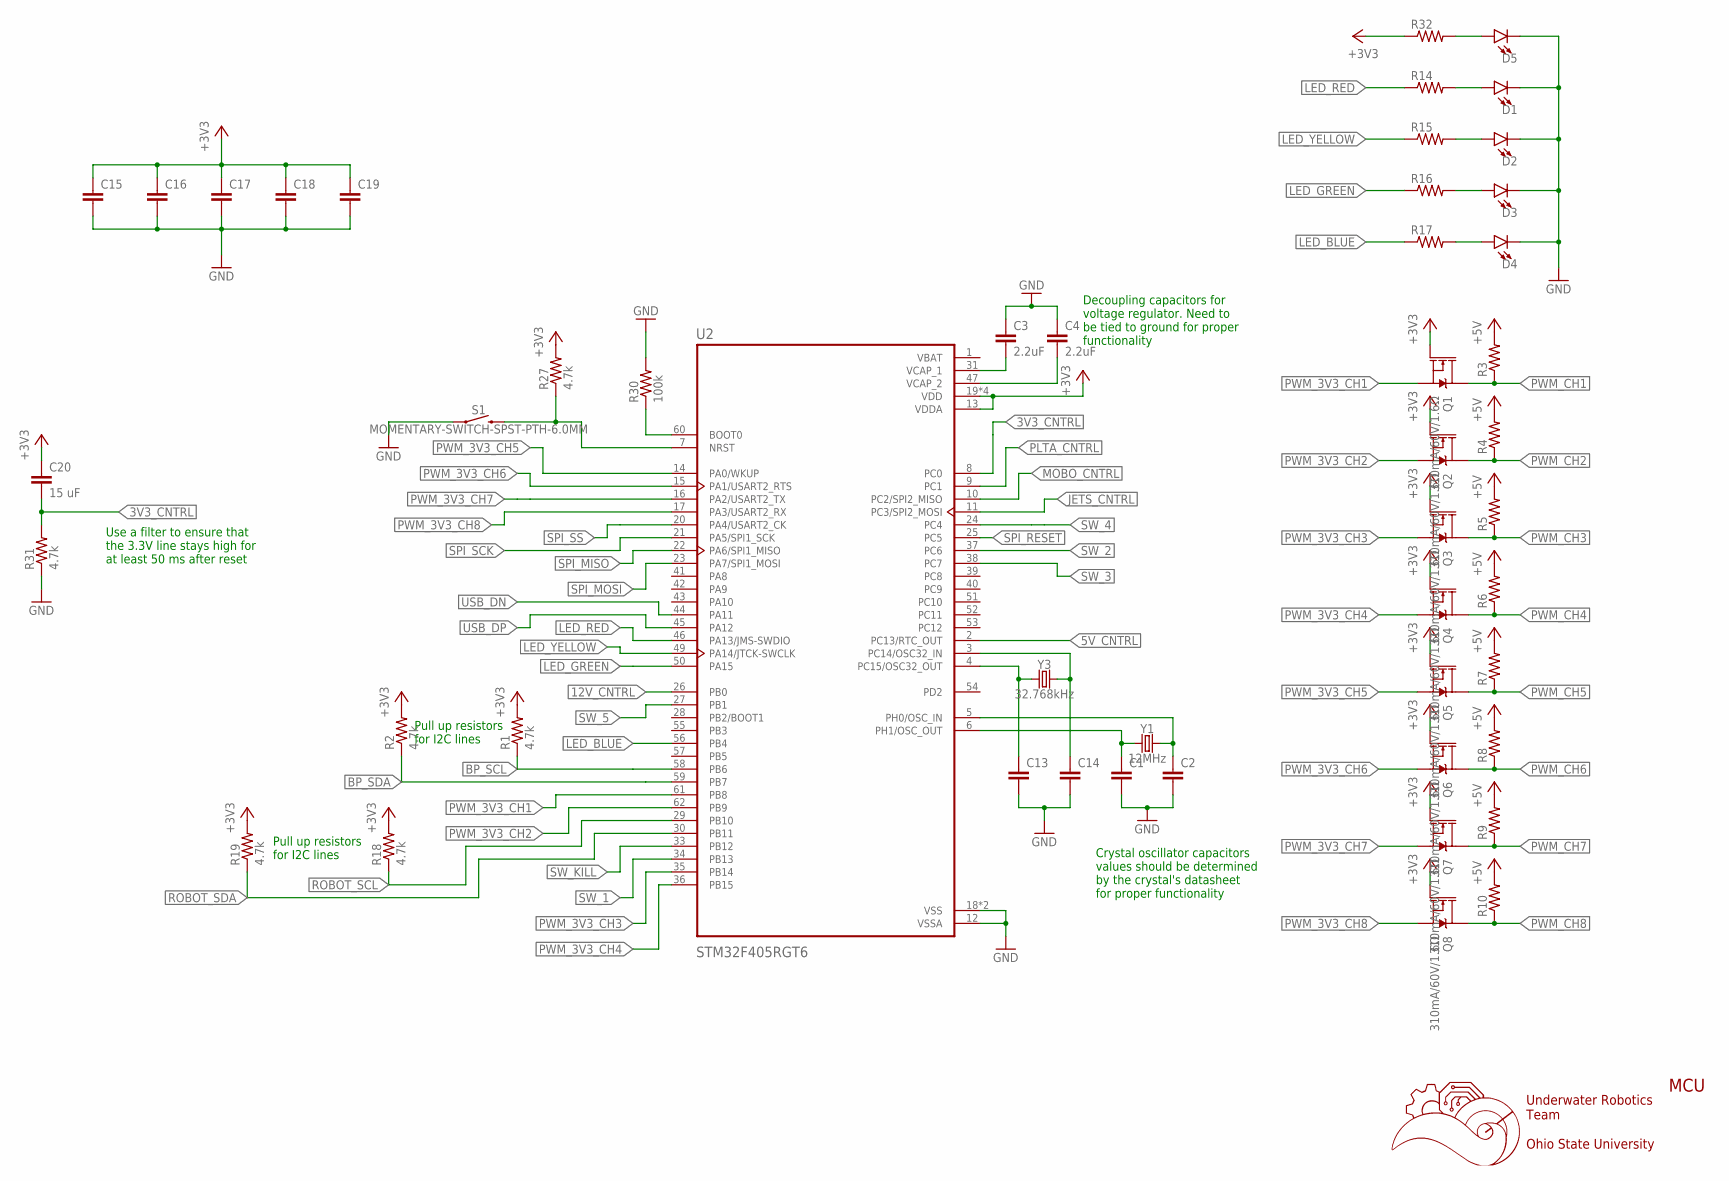
[picture p11: schematic CoProcessor.sch, sheet 2, MCU]

Parts:
C1, C2, C13, C14, C15, C16, C17, C18, C19: C-EUC0603; C0603
C3, C4: 2.2uF; C0603
C20: 15 uF; C050-025X075
D1, D2, D3, D4, D5: LED0603; LED-0603
Q1, Q2, Q3, Q4, Q5, Q6, Q7, Q8: 310mA/60V/1.6Ω; SOT323
R1, R2, R18, R19, R27, R31: 4.7k; R0603
R3, R4, R5, R6, R7, R8, R9, R10, R14, R15, R16, R17, R32: R-US_R0603; R0603
R30: 100k; R0603
S1: MOMENTARY-SWITCH-SPST-PTH-6.0MM; TACTILE_SWITCH_PTH_6.0MM
U2: STM32F405RGT6; QFP50P1200X1200X160-64N
Y1: 12MHz; HC49US
Y3: 32.768kHz; CRYSTAL-SMD-3.2X1.5MM

Connections:
3V3_CNTRL: C20.2, R31.2, U2.8 (PC0); also elsewhere on the board
5V_CNTRL: U2.2 (PC13/RTC_OUT); also elsewhere on the board
12V_CNTRL: U2.26 (PB0); also elsewhere on the board
+3V3: C15.1, C16.1, C17.1, C18.1, C19.1, C20.1, Q1.1 (G), Q2.1 (G), Q3.1 (G), Q4.1 (G), Q5.1 (G), Q6.1 (G), Q7.1 (G), Q8.1 (G), R1.2, R2.2, R18.2, R19.2, R27.2, R32.1, U2.13 (VDDA), U2.19 (VDD), U2.32 (VDD), U2.48 (VDD), U2.64 (VDD); also elsewhere on the board
+5V: R3.2, R4.2, R5.2, R6.2, R7.2, R8.2, R9.2, R10.2; also elsewhere on the board
BP_SCL: R1.1, U2.58 (PB6); also elsewhere on the board
BP_SDA: R2.1, U2.59 (PB7); also elsewhere on the board
GND: C1.2, C2.2, C3.1, C4.1, C13.2, C14.2, C15.2, C16.2, C17.2, C18.2, C19.2, D1.C, D2.C, D3.C, D4.C, D5.C, R30.2, R31.1, S1.1, U2.12 (VSSA), U2.18 (VSS), U2.63 (VSS); also elsewhere on the board
JETS_CNTRL: U2.11 (PC3/SPI2_MOSI); also elsewhere on the board
LED_BLUE: R17.1, U2.56 (PB4)
LED_GREEN: R16.1, U2.50 (PA15)
LED_RED: R14.1, U2.46 (PA13/JMS-SWDIO); also elsewhere on the board
LED_YELLOW: R15.1, U2.49 (PA14/JTCK-SWCLK); also elsewhere on the board
MOBO_CNTRL: U2.10 (PC2/SPI2_MISO); also elsewhere on the board
unnamed: C1.1, U2.6 (PH1/OSC_OUT), Y1.1
unnamed: D1.A, R14.2
unnamed: D2.A, R15.2
unnamed: D3.A, R16.2
unnamed: D4.A, R17.2
unnamed: C2.1, U2.5 (PH0/OSC_IN), Y1.2
unnamed: C4.2, U2.47 (VCAP_2)
unnamed: C3.2, U2.31 (VCAP_1)
unnamed: C13.1, U2.4 (PC15/OSC32_OUT), Y3.P$1 (1)
unnamed: C14.1, U2.3 (PC14/OSC32_IN), Y3.P$2 (2)
unnamed: R30.1, U2.60 (BOOT0)
unnamed: D5.A, R32.2
unnamed: R27.1, S1.3 (2), U2.7 (NRST)
PLTA_CNTRL: U2.9 (PC1); also elsewhere on the board
PWM_3V3_CH1: Q1.2 (S), U2.61 (PB8)
PWM_3V3_CH2: Q2.2 (S), U2.62 (PB9)
PWM_3V3_CH3: Q3.2 (S), U2.35 (PB14)
PWM_3V3_CH4: Q4.2 (S), U2.36 (PB15)
PWM_3V3_CH5: Q5.2 (S), U2.14 (PA0/WKUP)
PWM_3V3_CH6: Q6.2 (S), U2.15 (PA1/USART2_RTS)
PWM_3V3_CH7: Q7.2 (S), U2.16 (PA2/USART2_TX)
PWM_3V3_CH8: Q8.2 (S), U2.17 (PA3/USART2_RX)
PWM_CH1: Q1.3 (D), R3.1; also elsewhere on the board
PWM_CH2: Q2.3 (D), R4.1; also elsewhere on the board
PWM_CH3: Q3.3 (D), R5.1; also elsewhere on the board
PWM_CH4: Q4.3 (D), R6.1; also elsewhere on the board
PWM_CH5: Q5.3 (D), R7.1; also elsewhere on the board
PWM_CH6: Q6.3 (D), R8.1; also elsewhere on the board
PWM_CH7: Q7.3 (D), R9.1; also elsewhere on the board
PWM_CH8: Q8.3 (D), R10.1; also elsewhere on the board
ROBOT_SCL: R18.1, U2.29 (PB10); also elsewhere on the board
ROBOT_SDA: R19.1, U2.30 (PB11); also elsewhere on the board
SPI_MISO: U2.22 (PA6/SPI1_MISO); also elsewhere on the board
SPI_MOSI: U2.23 (PA7/SPI1_MOSI); also elsewhere on the board
SPI_RESET: U2.25 (PC5); also elsewhere on the board
SPI_SCK: U2.21 (PA5/SPI1_SCK); also elsewhere on the board
SPI_SS: U2.20 (PA4/USART2_CK); also elsewhere on the board
SW_1: U2.34 (PB13); also elsewhere on the board
SW_2: U2.37 (PC6); also elsewhere on the board
SW_3: U2.38 (PC7); also elsewhere on the board
SW_4: U2.24 (PC4); also elsewhere on the board
SW_5: U2.27 (PB1); also elsewhere on the board
SW_KILL: U2.33 (PB12); also elsewhere on the board
USB_DN: U2.44 (PA11); also elsewhere on the board
USB_DP: U2.45 (PA12); also elsewhere on the board
VBAT: U2.1 (VBAT)

Notes on the sheet:
Underwater Robotics Team Ohio State University
MCU
Pull up resistors for I2C lines
Decoupling capacitors for voltage regulator. Need to be tied to ground for proper functionality
Crystal oscillator capacitors values should be determined by the crystal's datasheet for proper functionality
Use a filter to ensure that the 3.3V line stays high for at least 50 ms after reset

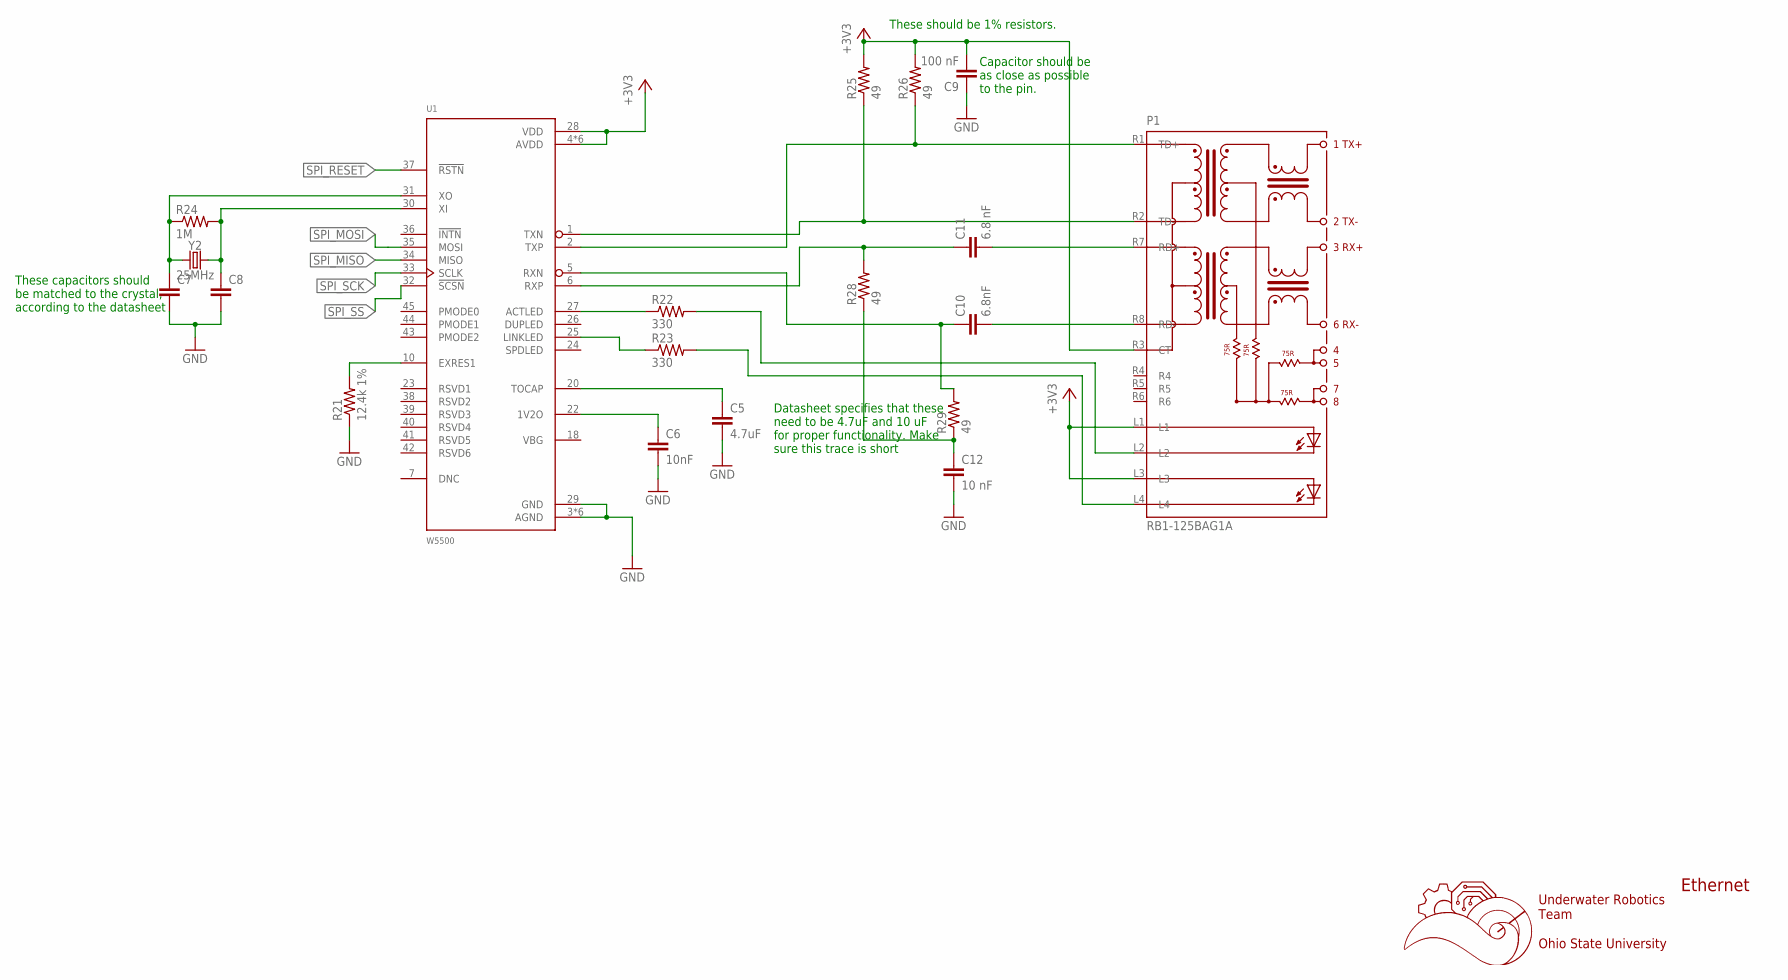
[picture p12: schematic CoProcessor.sch, sheet 3, Ethernet]

Parts:
C5: 4.7uF; C0603
C6: 10nF; C0603
C7, C8: C-EUC0603; C0603
C9: 100 nF; C0603
C10: 6.8nF; C0603
C11: 6.8 nF; C0603
C12: 10 nF; C0603
P1: RB1-125BAG1A; WIZNET_RB1-125BAG1A
R21: 12.4k 1%; R0603
R22, R23: 330; R0603
R24: 1M; R0603
R25, R26, R28, R29: 49; R0603
U1: W5500; QFP50P900X900X160-48N
Y2: 25MHz; HC49US

Connections:
+3V3: C9.2, P1.L1, P1.L3, P1.R3 (CT), R25.2, R26.2, U1.4 (AVDD), U1.8 (AVDD), U1.11 (AVDD), U1.15 (AVDD), U1.17 (AVDD), U1.21 (AVDD), U1.28 (VDD); also elsewhere on the board
GND: C5.2, C6.2, C7.2, C8.2, C9.1, C12.2, R21.1, U1.3 (AGND), U1.9 (AGND), U1.14 (AGND), U1.16 (AGND), U1.19 (AGND), U1.29 (GND), U1.48 (AGND); also elsewhere on the board
unnamed: C5.1, U1.20 (TOCAP)
unnamed: C6.1, U1.22 (1V2O)
unnamed: R21.2, U1.10 (EXRES1)
unnamed: P1.R2 (TD-), R25.1, U1.1 (TXN)
unnamed: P1.R1 (TD+), R26.1, U1.2 (TXP)
unnamed: C10.1, R29.2, U1.5 (RXN)
unnamed: C11.1, R28.2, U1.6 (RXP)
unnamed: P1.L2, R22.2
unnamed: P1.L4, R23.2
unnamed: R22.1, U1.27 (ACTLED)
unnamed: R23.1, U1.25 (LINKLED)
unnamed: C8.1, R24.2, U1.30 (XI), Y2.2
unnamed: C7.1, R24.1, U1.31 (XO), Y2.1
unnamed: C10.2, P1.R8 (RD-)
unnamed: C11.2, P1.R7 (RD+)
unnamed: C12.1, R28.1, R29.1
SPI_MISO: U1.34 (MISO); also elsewhere on the board
SPI_MOSI: U1.35 (MOSI); also elsewhere on the board
SPI_RESET: U1.37 (!RSTN); also elsewhere on the board
SPI_SCK: U1.33 (SCLK); also elsewhere on the board
SPI_SS: U1.32 (!SCSN); also elsewhere on the board

Notes on the sheet:
Underwater Robotics Team Ohio State University
Ethernet
Datasheet specifies that these need to be 4.7uF and 10 uF for proper functionality. Make sure this trace is short
These capacitors should be matched to the crystal, according to the datasheet
These should be 1% resistors.
Capacitor should be as close as possible to the pin.

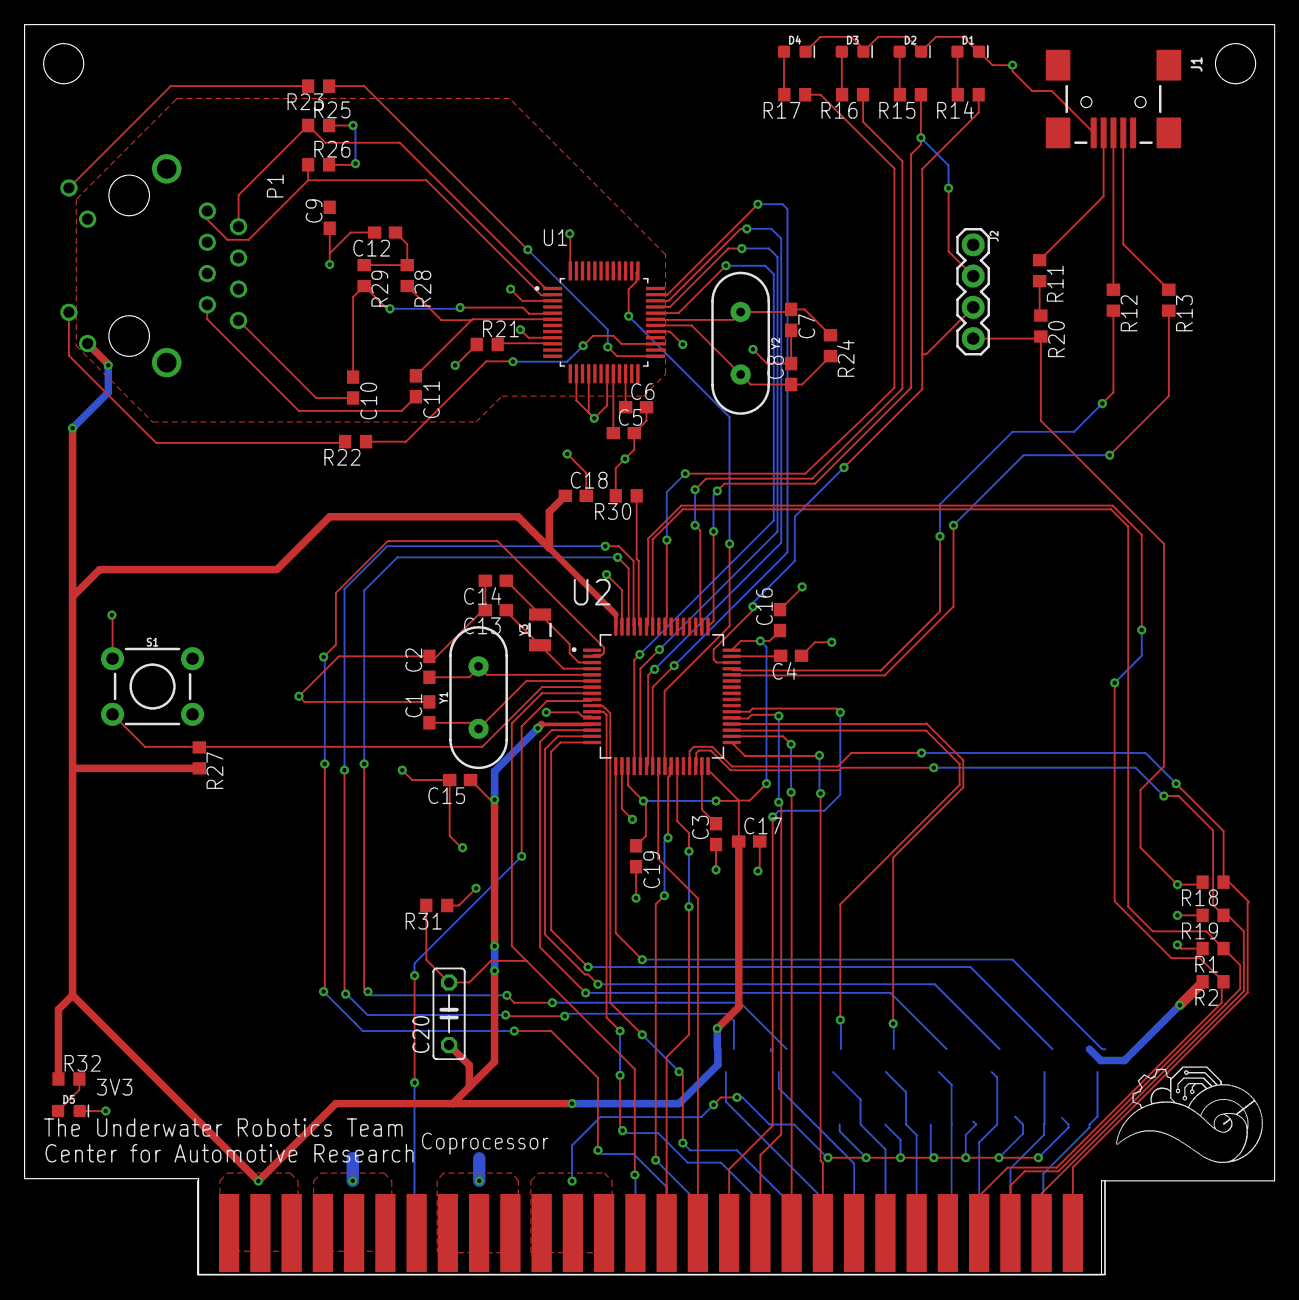
[picture p13: board CoProcessor.brd from above]

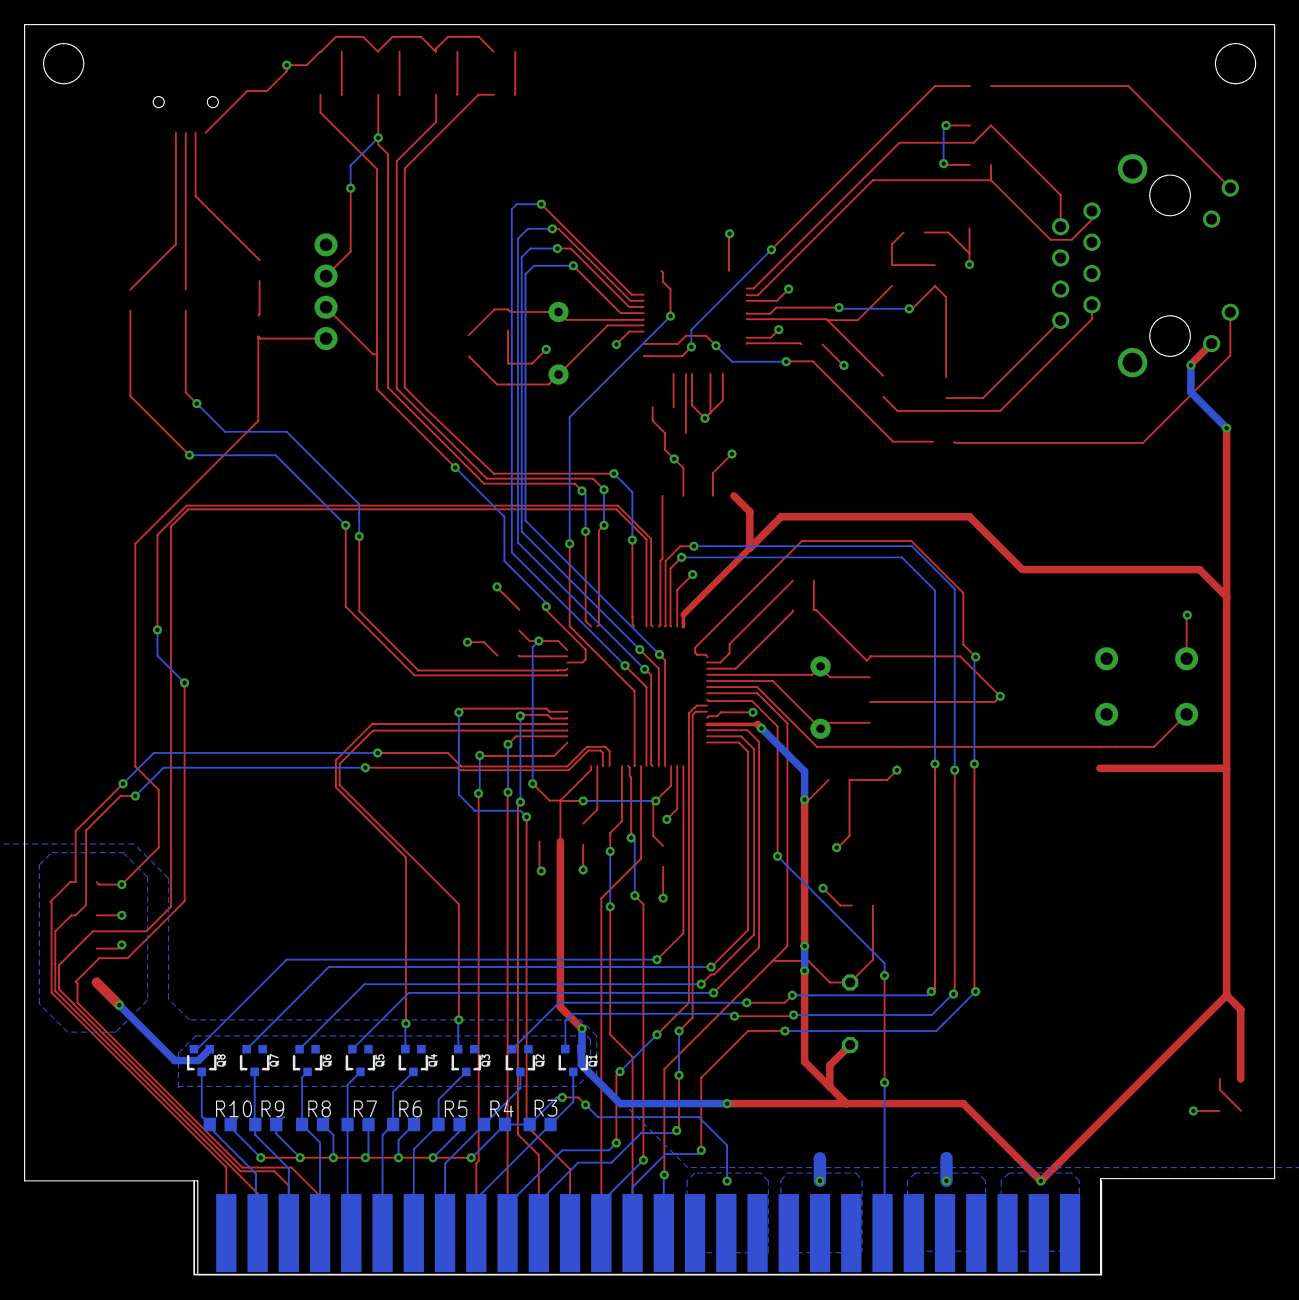
[picture p14: board CoProcessor.brd from below]

Board: 2 copper layers, 101.6 x 101.6 mm, 75 parts (16 on the bottom side), 79 nets.
