SKhatri1029/uwrt_electronics/Maelstrom Boards/ESC/ESC.brd

## EAGLE design Maelstrom Boards/ESC/ESC.brd (2019-02-17)

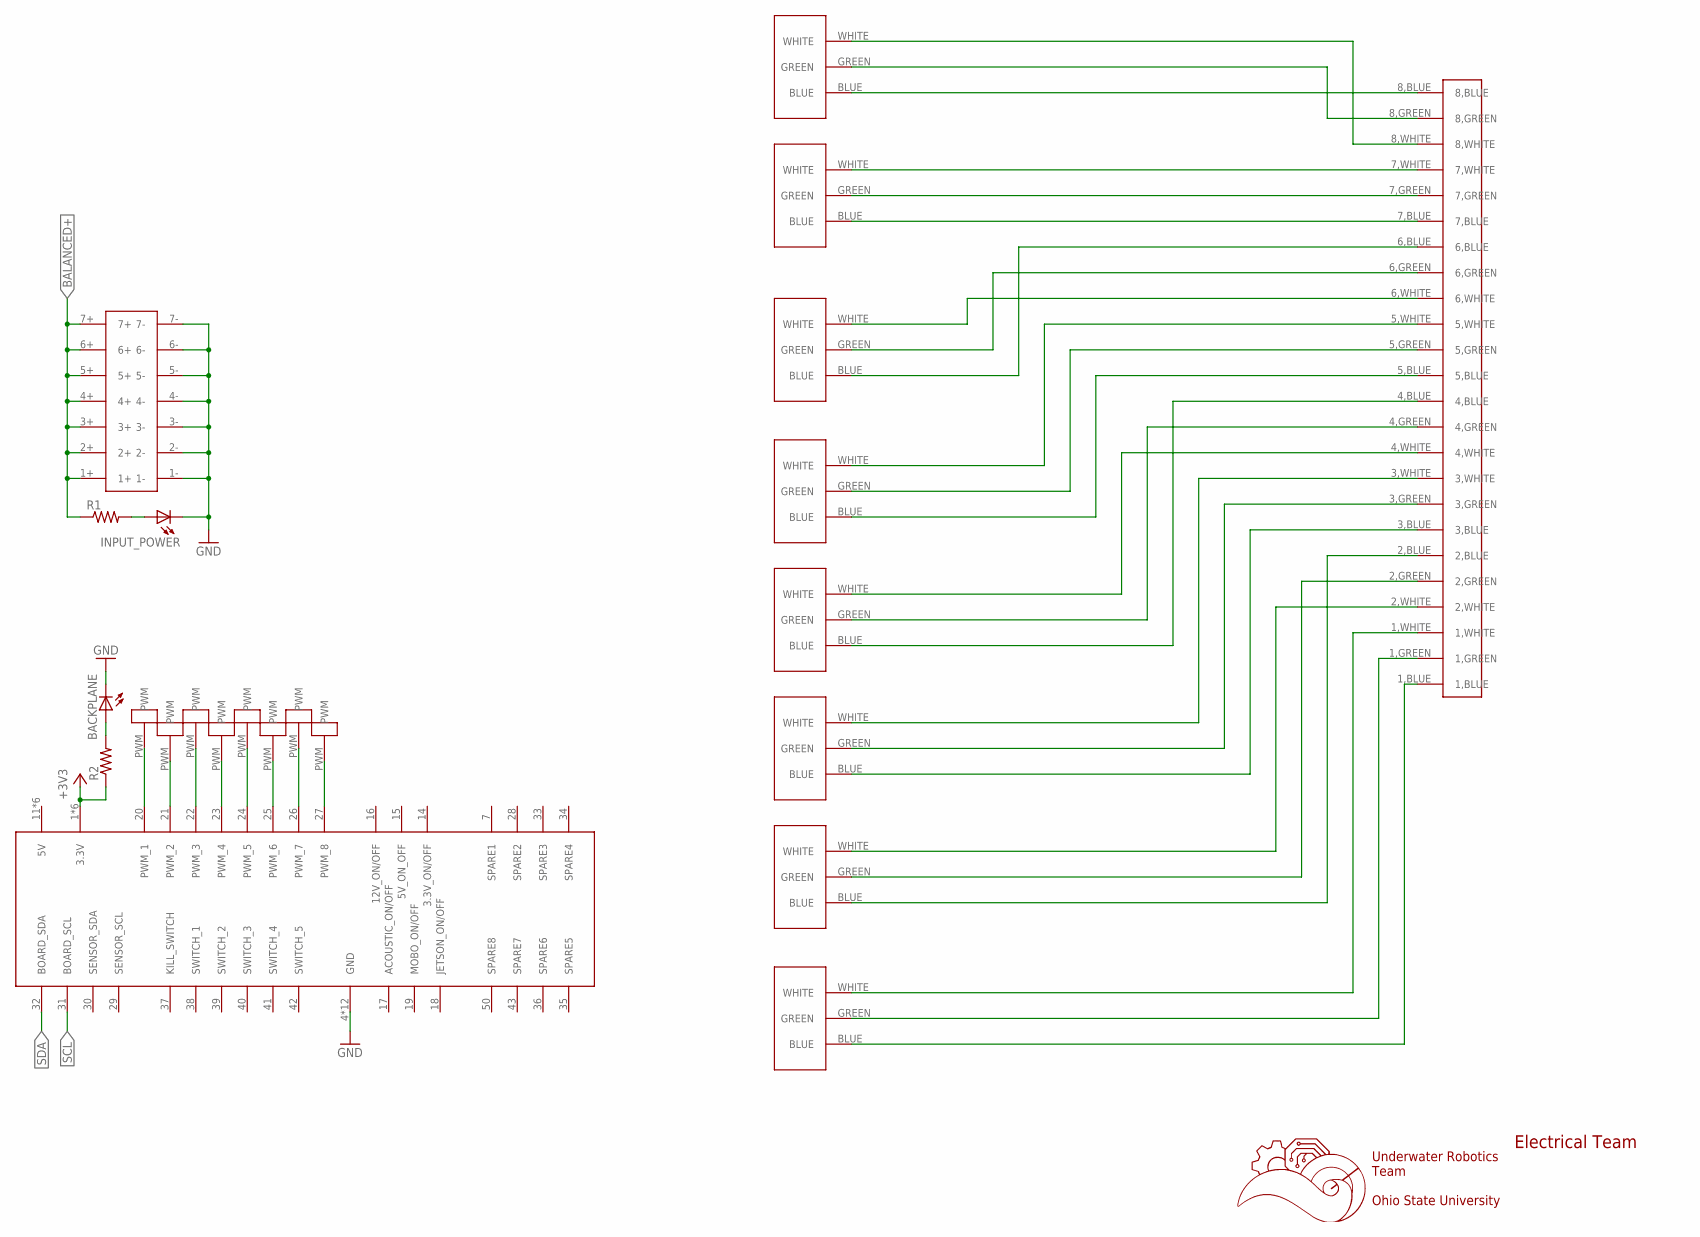
[picture p15: schematic ESC.sch, sheet 1, Connectors]

Parts:
1, 2, 3, 4, 5, 6, 7, 8: 1711738
BACKPLANE: LEDCHIPLED_0603; CHIPLED_0603
INPUT_POWER: LEDCHIPLED_0603; CHIPLED_0603
P5, P6, P7, P8: MALE1PINHEADER
R1, R2: R-US_R0603; R0603
U$1: 5530843-EDGE; 5530843-6-BOARDFINGERS
U$18: 24PINCONVERTER
U$19: 14PIN_VERT
U$20, U$21, U$22, U$23: MALE1PINHEADER

Connections:
+3V3: R2.1, U$1.1 (3.3V), U$1.2 (3.3V), U$1.3 (3.3V), U$1.54 (3.3V), U$1.55 (3.3V), U$1.56 (3.3V); also elsewhere on the board
BALANCED+: R1.1, U$19.1+, U$19.2+, U$19.3+, U$19.4+, U$19.5+, U$19.6+, U$19.7+; also elsewhere on the board
GND: BACKPLANE.C, INPUT_POWER.C, U$1.4 (GND), U$1.5 (GND), U$1.6 (GND), U$1.8 (GND), U$1.9 (GND), U$1.10 (GND), U$1.47 (GND), U$1.48 (GND), U$1.49 (GND), U$1.51 (GND), U$1.52 (GND), U$1.53 (GND), U$19.1-, U$19.2-, U$19.3-, U$19.4-, U$19.5-, U$19.6-, U$19.7-; also elsewhere on the board
unnamed: 1.GREEN, U$18.1,GREEN
unnamed: 8.WHITE, U$18.8,WHITE
unnamed: 8.GREEN, U$18.8,GREEN
unnamed: 8.BLUE, U$18.8,BLUE
unnamed: 7.GREEN, U$18.7,GREEN
unnamed: 7.BLUE, U$18.7,BLUE
unnamed: 6.WHITE, U$18.6,WHITE
unnamed: 6.GREEN, U$18.6,GREEN
unnamed: 6.BLUE, U$18.6,BLUE
unnamed: 5.WHITE, U$18.5,WHITE
unnamed: 5.GREEN, U$18.5,GREEN
unnamed: 5.BLUE, U$18.5,BLUE
unnamed: 4.WHITE, U$18.4,WHITE
unnamed: 4.GREEN, U$18.4,GREEN
unnamed: 4.BLUE, U$18.4,BLUE
unnamed: 3.BLUE, U$18.3,BLUE
unnamed: 3.WHITE, U$18.3,WHITE
unnamed: 3.GREEN, U$18.3,GREEN
unnamed: 2.WHITE, U$18.2,WHITE
unnamed: 2.GREEN, U$18.2,GREEN
unnamed: 2.BLUE, U$18.2,BLUE
unnamed: 1.WHITE, U$18.1,WHITE
unnamed: 7.WHITE, U$18.7,WHITE
unnamed: 1.BLUE, U$18.1,BLUE
unnamed: INPUT_POWER.A, R1.2
unnamed: BACKPLANE.A, R2.2
PWM_1: U$1.20 (PWM_1), U$20.PWM
PWM_2: U$1.21 (PWM_2), U$21.PWM
PWM_3: U$1.22 (PWM_3), U$22.PWM
PWM_4: U$1.23 (PWM_4), U$23.PWM
PWM_5: P5.PWM, U$1.24 (PWM_5)
PWM_6: P6.PWM, U$1.25 (PWM_6)
PWM_7: P7.PWM, U$1.26 (PWM_7)
PWM_8: P8.PWM, U$1.27 (PWM_8)
SCL: U$1.31 (BOARD_SCL); also elsewhere on the board
SDA: U$1.32 (BOARD_SDA); also elsewhere on the board

Notes on the sheet:
Underwater Robotics Team Ohio State University
Electrical Team

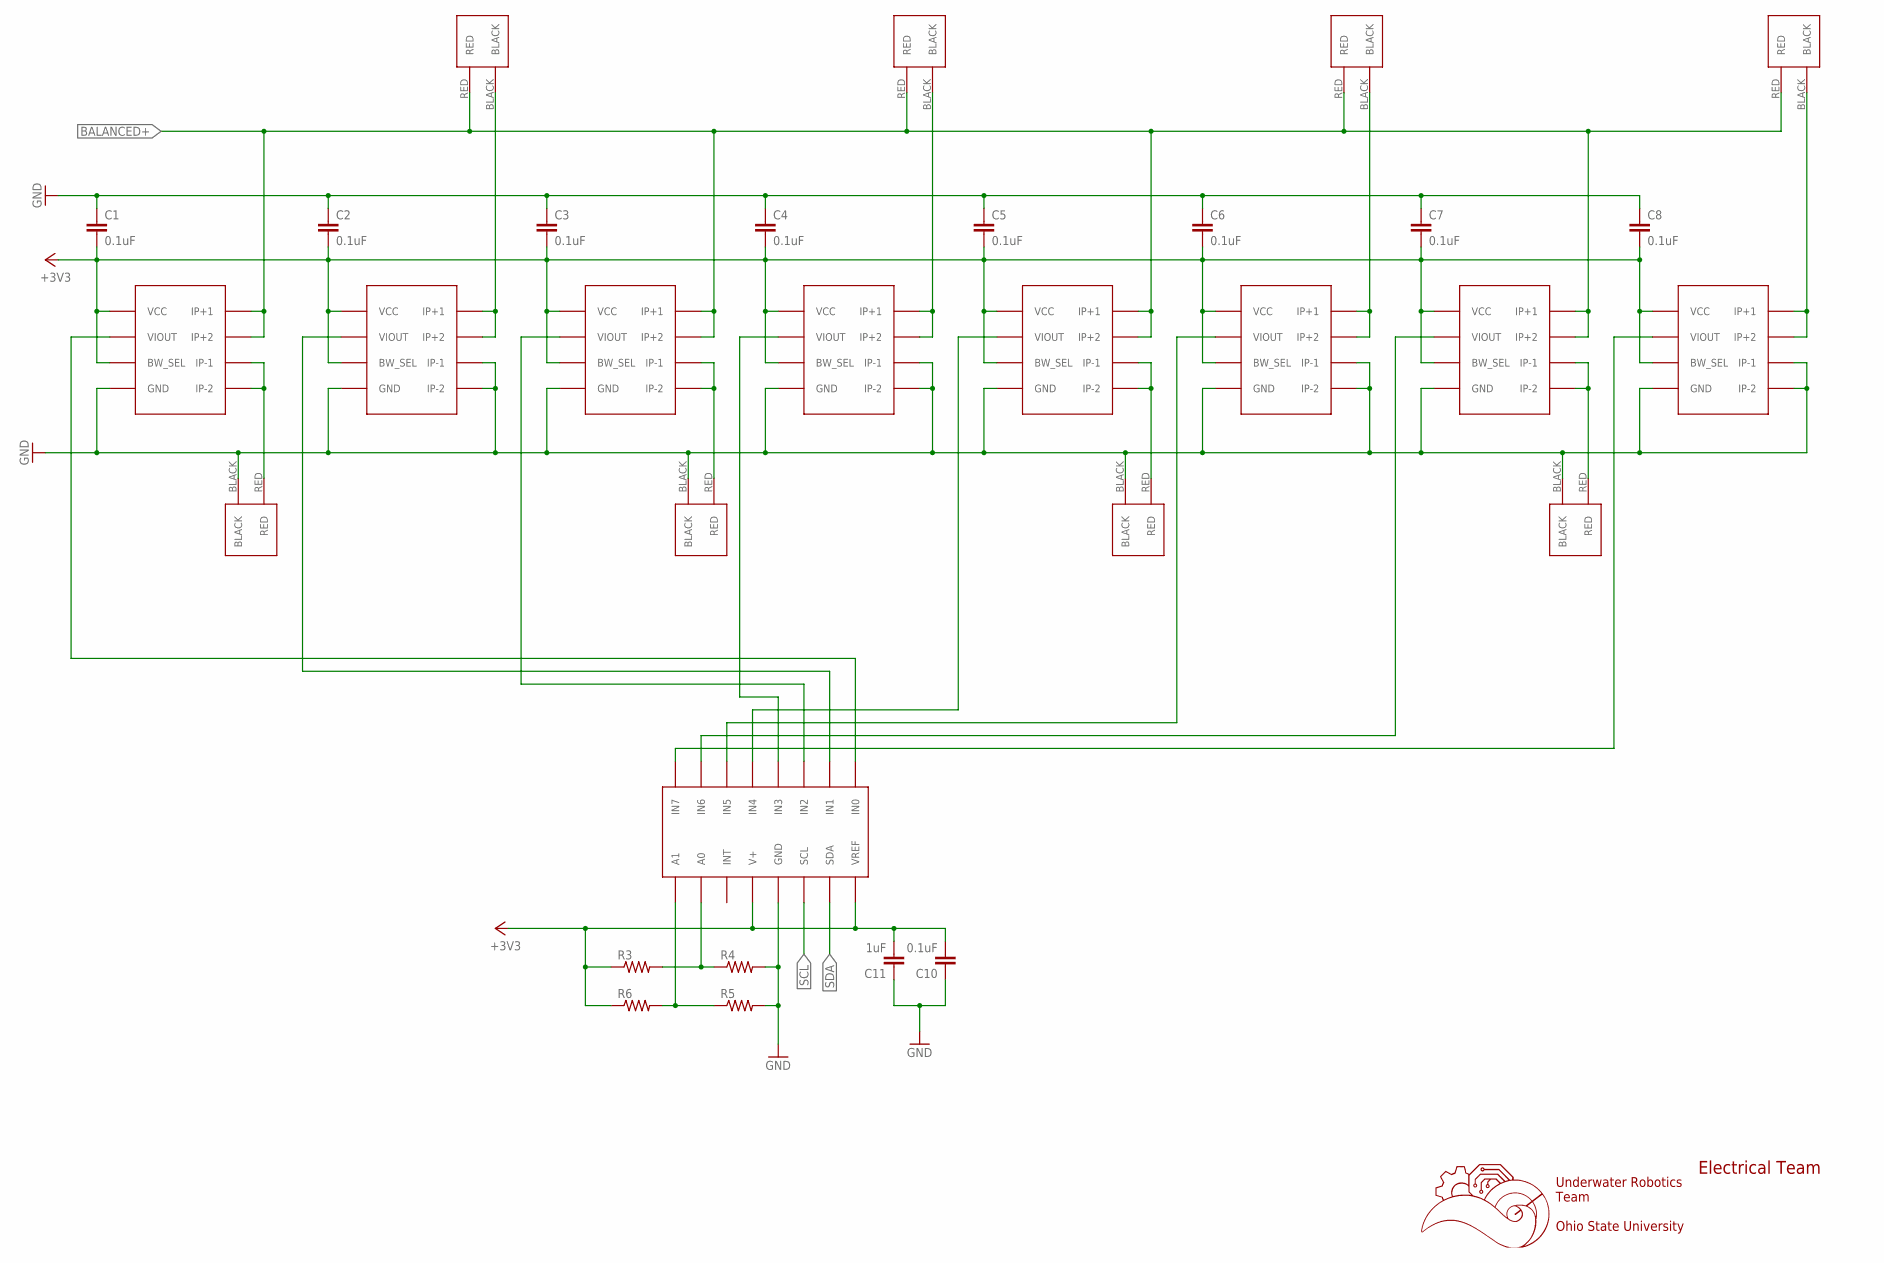
[picture p16: schematic ESC.sch, sheet 2]

Parts:
1C, 2C, 3C, 4C, 5C, 6C, 7C, 8C: ACS722; SOIC-8
1CONNECT, 2CONNECT, 3CONNECT, 4CONNECT, 5CONNECT, 7CONNECT, 8CONNECT: 1711725
C1, C2, C3, C4, C5, C6, C7, C8, C10: 0.1uF; C0603
C11: 1uF; C0603
CONNECT: 1711725
R3, R4, R5, R6: R-US_R0603; R0603
U$24: ADC128D818; TSSOP-16

Connections:
0ADC: 1C.VIOUT, U$24.IN0
1ADC: 2C.VIOUT, U$24.IN1
2ADC: 3C.VIOUT, U$24.IN2
3ADC: 4C.VIOUT, U$24.IN3
4ADC: 5C.VIOUT, U$24.IN4
5ADC: 6C.VIOUT, U$24.IN5
6ADC: 7C.VIOUT, U$24.IN6
7ADC: 8C.VIOUT, U$24.IN7
+3V3: 1C.BW_SEL, 1C.VCC, 2C.BW_SEL, 2C.VCC, 3C.BW_SEL, 3C.VCC, 4C.BW_SEL, 4C.VCC, 5C.BW_SEL, 5C.VCC, 6C.BW_SEL, 6C.VCC, 7C.BW_SEL, 7C.VCC, 8C.BW_SEL, 8C.VCC, C1.2, C2.2, C3.2, C4.2, C5.2, C6.2, C7.2, C8.2, C10.2, C11.2, R3.1, R6.1, U$24.V+, U$24.VREF; also elsewhere on the board
BALANCED+: 1C.IP+1, 1C.IP+2, 2CONNECT.RED, 3C.IP+1, 3C.IP+2, 4CONNECT.RED, 5C.IP+1, 5C.IP+2, 7C.IP+1, 7C.IP+2, 8CONNECT.RED, CONNECT.RED; also elsewhere on the board
GND: 1C.GND, 1CONNECT.BLACK, 2C.GND, 2C.IP-1, 2C.IP-2, 3C.GND, 3CONNECT.BLACK, 4C.GND, 4C.IP-1, 4C.IP-2, 5C.GND, 5CONNECT.BLACK, 6C.GND, 6C.IP-1, 6C.IP-2, 7C.GND, 7CONNECT.BLACK, 8C.GND, 8C.IP-1, 8C.IP-2, C1.1, C2.1, C3.1, C4.1, C5.1, C6.1, C7.1, C8.1, C10.1, C11.1, R4.2, R5.2, U$24.GND; also elsewhere on the board
unnamed: 8C.IP+1, 8C.IP+2, 8CONNECT.BLACK
unnamed: 1C.IP-1, 1C.IP-2, 1CONNECT.RED
unnamed: 2C.IP+1, 2C.IP+2, 2CONNECT.BLACK
unnamed: 3C.IP-1, 3C.IP-2, 3CONNECT.RED
unnamed: 5C.IP-1, 5C.IP-2, 5CONNECT.RED
unnamed: 4C.IP+1, 4C.IP+2, 4CONNECT.BLACK
unnamed: 6C.IP+1, 6C.IP+2, CONNECT.BLACK
unnamed: 7C.IP-1, 7C.IP-2, 7CONNECT.RED
unnamed: R3.2, R4.1, U$24.A0
unnamed: R5.1, R6.2, U$24.A1
SCL: U$24.SCL; also elsewhere on the board
SDA: U$24.SDA; also elsewhere on the board

Notes on the sheet:
Underwater Robotics Team Ohio State University
Electrical Team

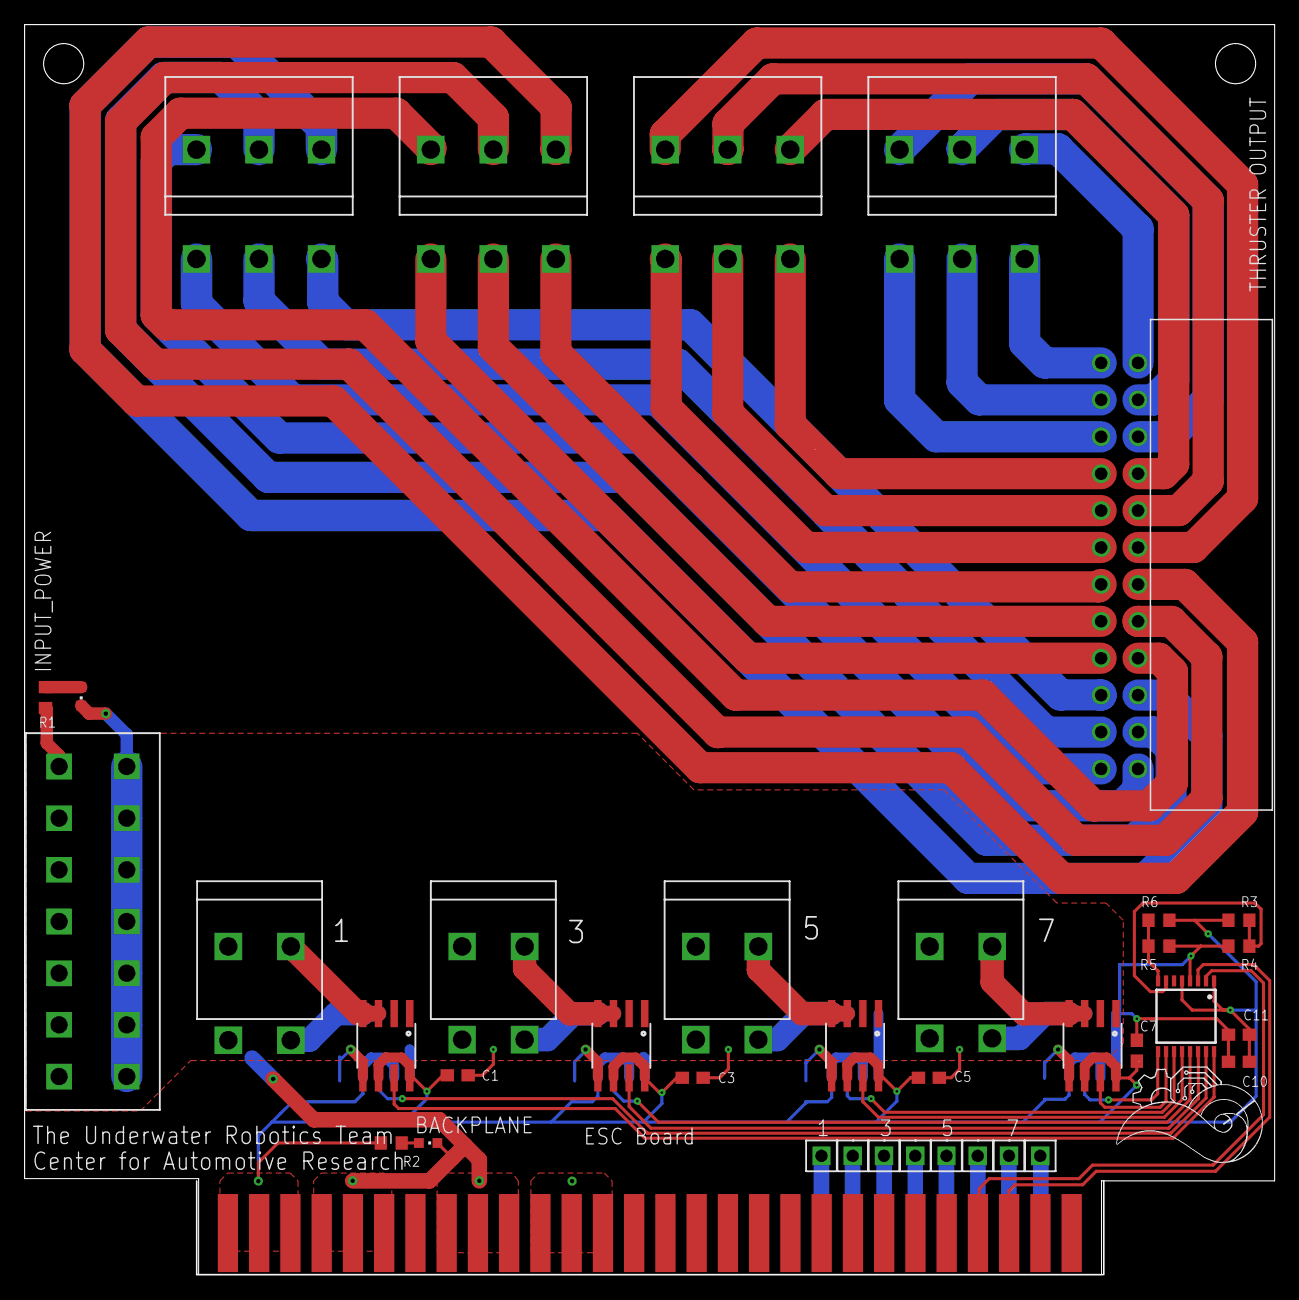
[picture p17: board ESC.brd from above]

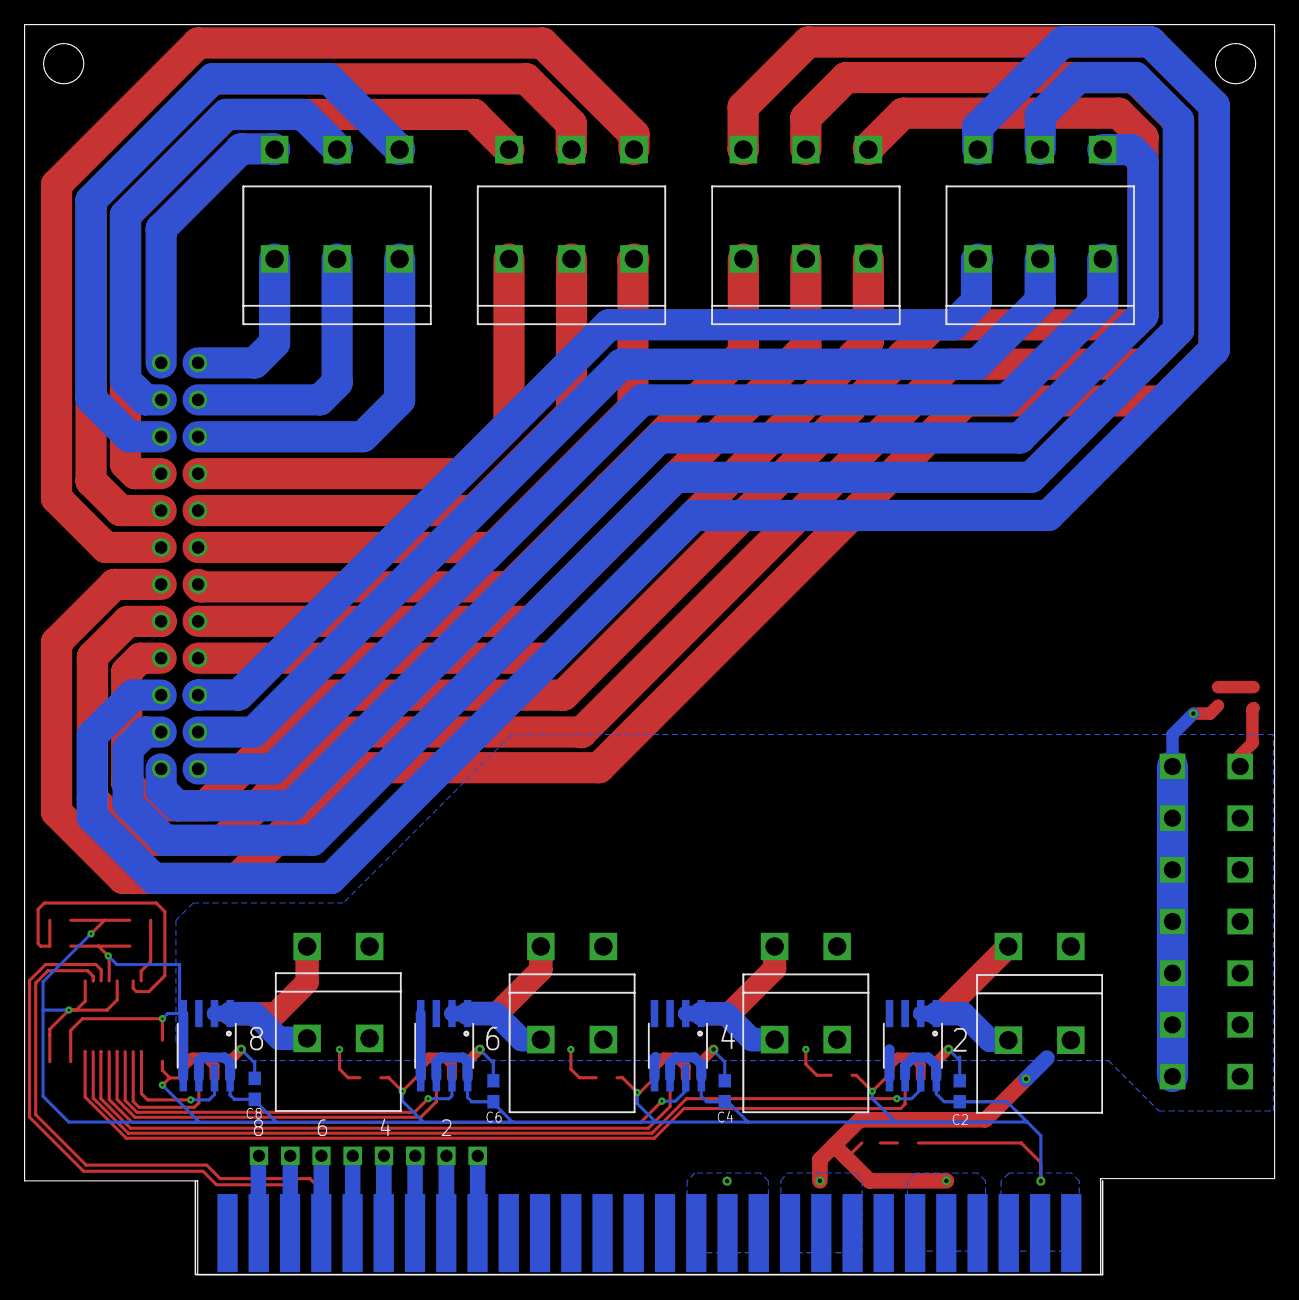
[picture p18: board ESC.brd from below]

Board: 2 copper layers, 101.6 x 101.6 mm, 54 parts (16 on the bottom side), 57 nets.
