SKhatri1029/uwrt_electronics/Maelstrom Boards/Converter/Converter.brd

## EAGLE design Maelstrom Boards/Converter/Converter.brd (2019-02-17)

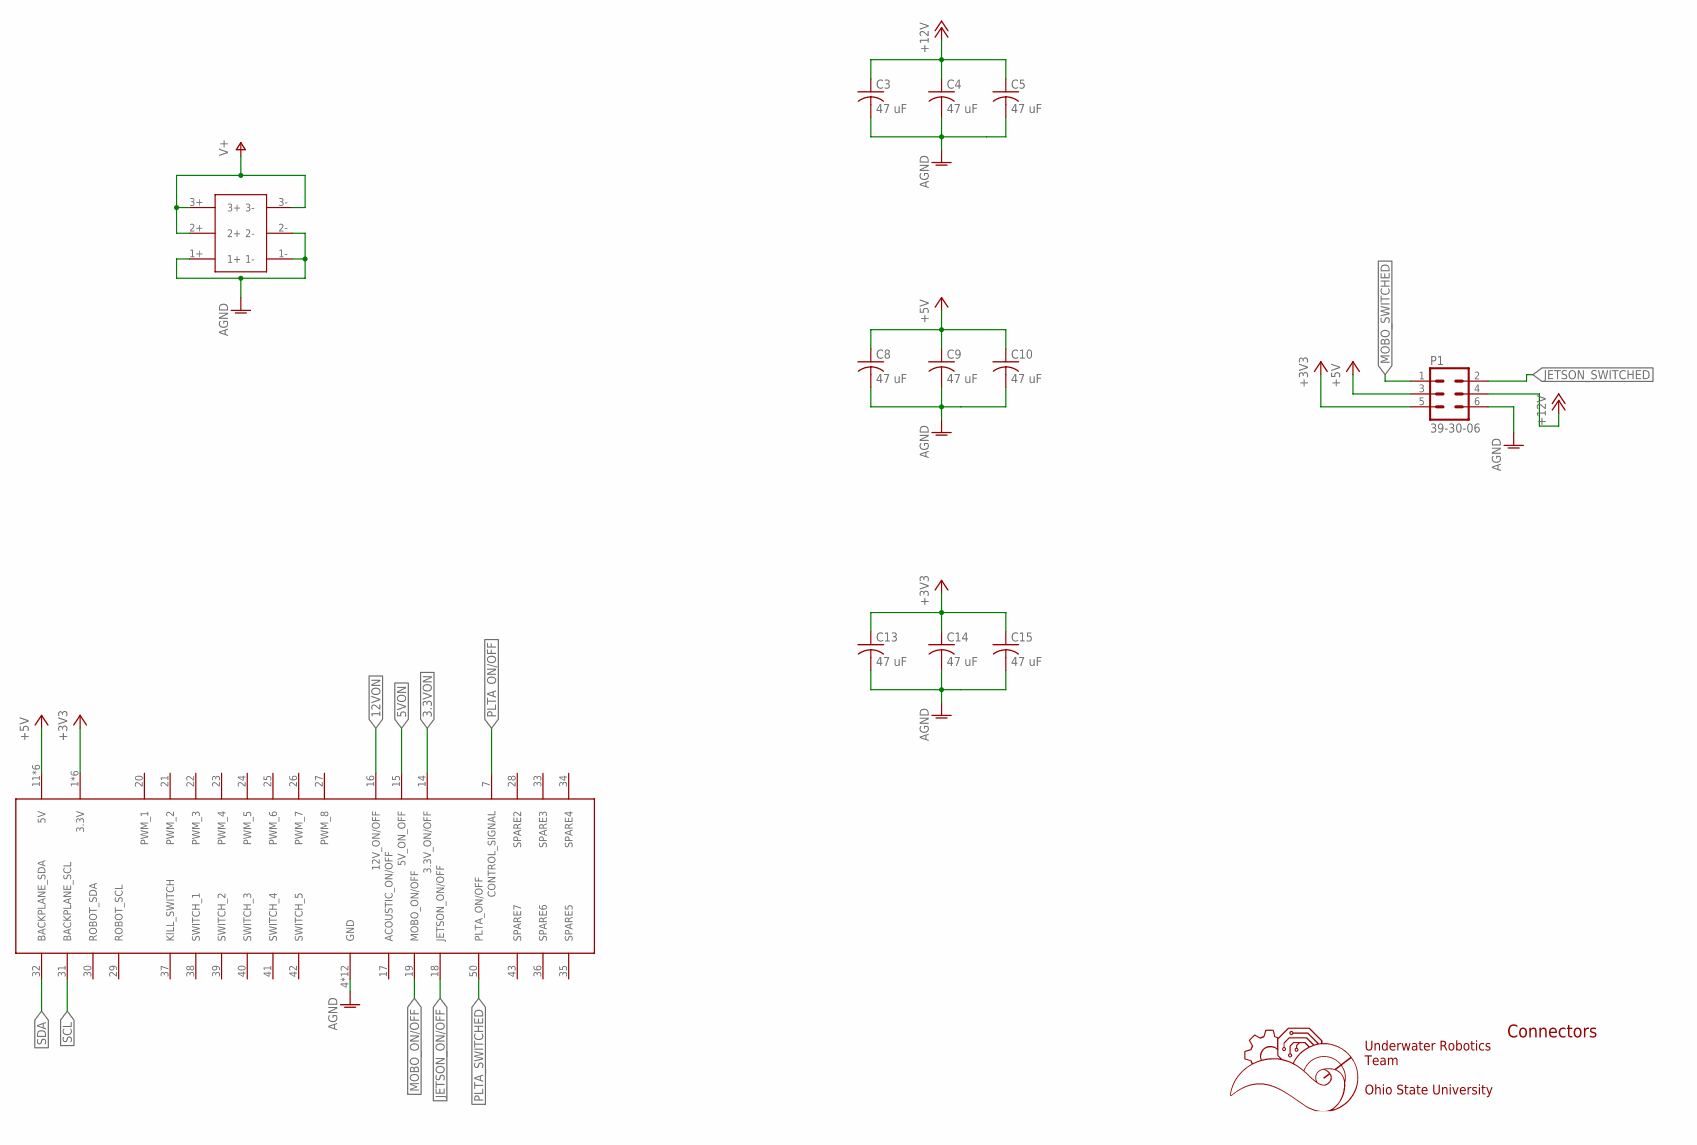
[picture p19: schematic Converter.sch, sheet 1, Connectors & Caps]

Parts:
C3, C4, C5, C8, C9, C10, C13, C14, C15: 47 uF; C1206K
P1: 39-30-06; 39-30-?06?
U$1: 5530843-EDGE; 5530843-6-BOARDFINGERS
U$3: 6PIN-VERT; 6PIN_VERT

Connections:
3.3VON: U$1.14 (3.3V_ON/OFF); also elsewhere on the board
5VON: U$1.15 (5V_ON_OFF); also elsewhere on the board
12VON: U$1.16 (12V_ON/OFF); also elsewhere on the board
+3V3: C13.1, C14.1, C15.1, P1.5, U$1.1 (3.3V), U$1.2 (3.3V), U$1.3 (3.3V), U$1.54 (3.3V), U$1.55 (3.3V), U$1.56 (3.3V); also elsewhere on the board
+5V: C8.1, C9.1, C10.1, P1.3, U$1.11 (5V), U$1.12 (5V), U$1.13 (5V), U$1.44 (5V), U$1.45 (5V), U$1.46 (5V); also elsewhere on the board
+12V: C3.1, C4.1, C5.1, P1.4; also elsewhere on the board
AGND: C3.2, C4.2, C5.2, C8.2, C9.2, C10.2, C13.2, C14.2, C15.2, P1.6, U$1.4 (GND), U$1.5 (GND), U$1.6 (GND), U$1.8 (GND), U$1.9 (GND), U$1.10 (GND), U$1.47 (GND), U$1.48 (GND), U$1.49 (GND), U$1.51 (GND), U$1.52 (GND), U$1.53 (GND), U$3.1+, U$3.1-, U$3.2-; also elsewhere on the board
JETSON_ON/OFF: U$1.18 (JETSON_ON/OFF); also elsewhere on the board
JETSON_SWITCHED: P1.2; also elsewhere on the board
MOBO_ON/OFF: U$1.19 (MOBO_ON/OFF); also elsewhere on the board
MOBO_SWITCHED: P1.1; also elsewhere on the board
PLTA_ON/OFF: U$1.7 (CONTROL_SIGNAL); also elsewhere on the board
PLTA_SWITCHED: U$1.50 (PLTA_ON/OFF); also elsewhere on the board
SCL: U$1.31 (BACKPLANE_SCL); also elsewhere on the board
SDA: U$1.32 (BACKPLANE_SDA); also elsewhere on the board
V+: U$3.2+, U$3.3+, U$3.3-; also elsewhere on the board

Notes on the sheet:
Underwater Robotics Team Ohio State University
Connectors

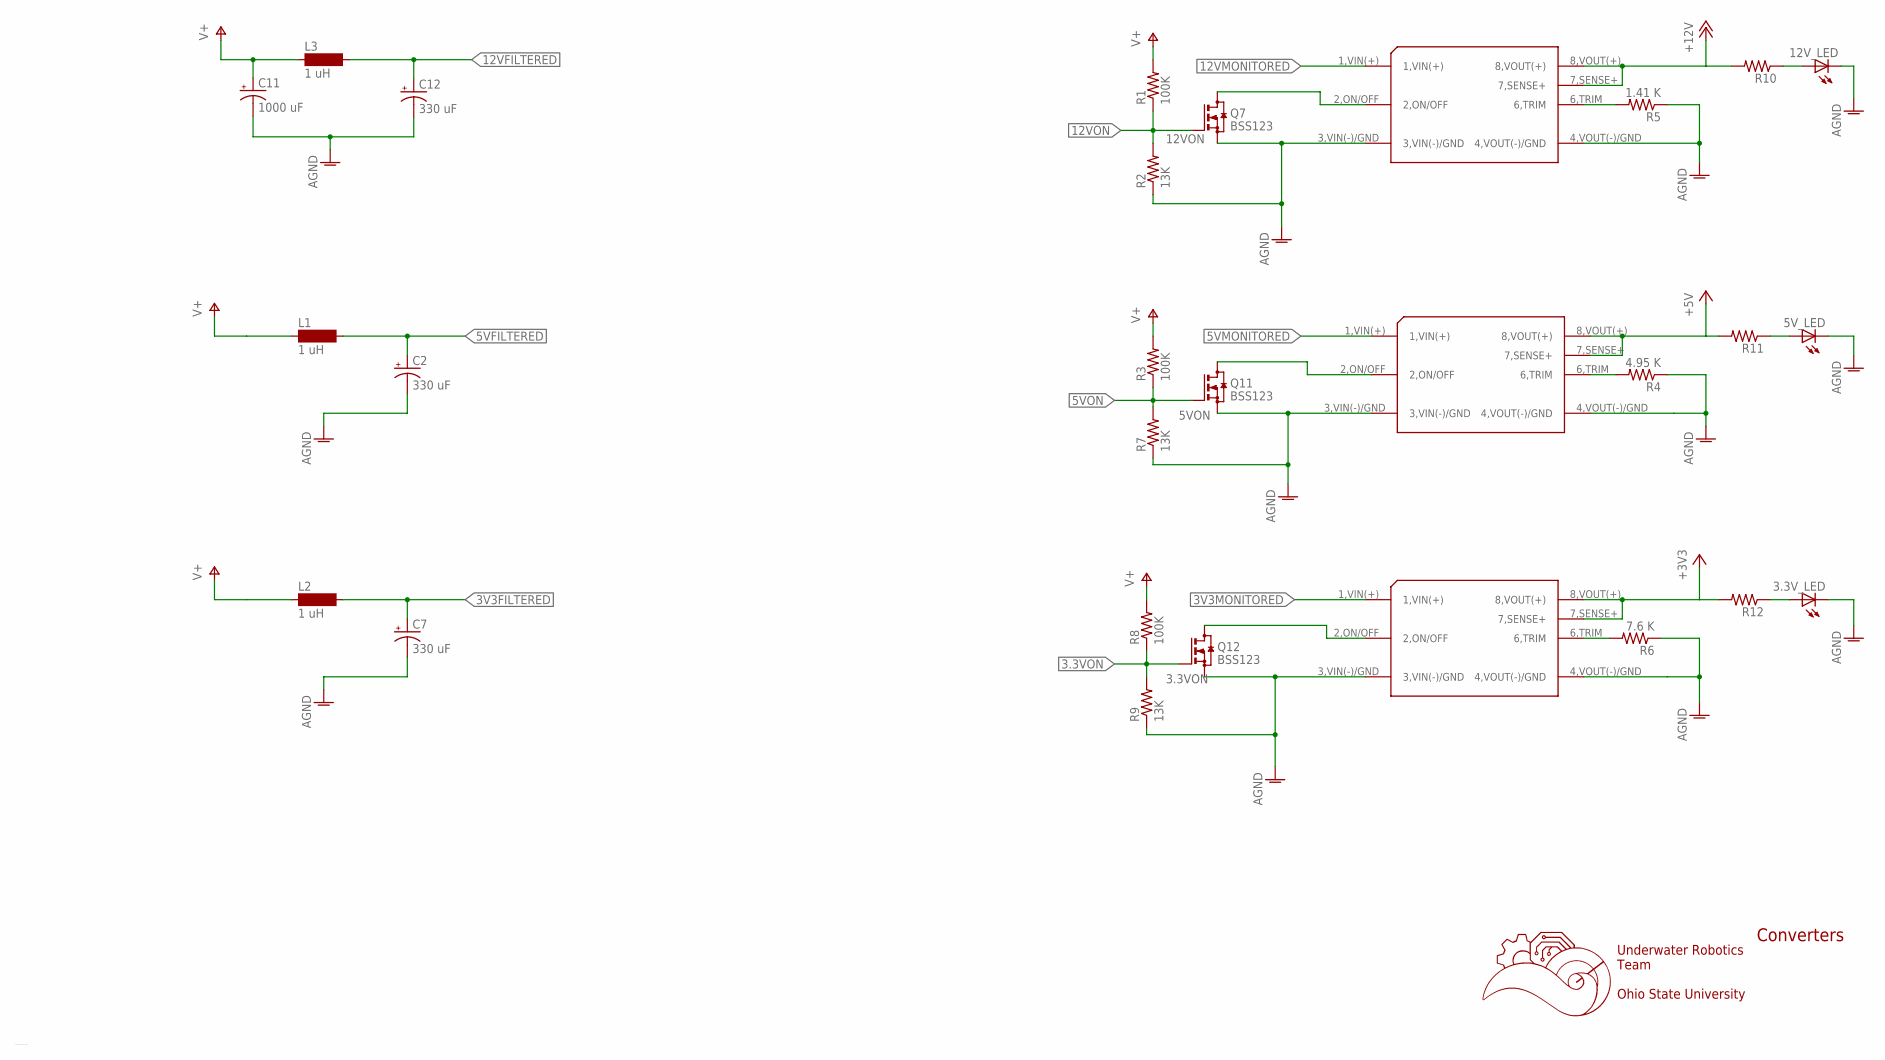
[picture p20: schematic Converter.sch, sheet 2]

Parts:
3.3VCONVERTER, 5VCONVERTER, 12VCONVERTER: CONVERTER
3.3V_LED, 5V_LED, 12V_LED: LEDCHIPLED_0603; CHIPLED_0603
C2, C7, C12: 330 uF; E5-10,5
C11: 1000 uF; E5-13
L1, L2, L3: 1 uH; MS85
Q7, Q11, Q12: BSS123; SOT23
R1, R3, R8: 100K; R0603
R2, R7, R9: 13K; R0603
R4: 4.95 K; R0603
R5: 1.41 K; R0603
R6: 7.6 K; R0603
R10, R11, R12: R-US_R0603; R0603

Connections:
3.3VON: Q12.1 (G), R8.1, R9.2; also elsewhere on the board
3V3FILTERED: C7.+, L2.2; also elsewhere on the board
3V3MONITORED: 3.3VCONVERTER.1,VIN(+); also elsewhere on the board
5VFILTERED: C2.+, L1.2; also elsewhere on the board
5VMONITORED: 5VCONVERTER.1,VIN(+); also elsewhere on the board
5VON: Q11.1 (G), R3.1, R7.2; also elsewhere on the board
12VFILTERED: C12.+, L3.2; also elsewhere on the board
12VMONITORED: 12VCONVERTER.1,VIN(+); also elsewhere on the board
12VON: Q7.1 (G), R1.1, R2.2; also elsewhere on the board
+3V3: 3.3VCONVERTER.7,SENSE+, 3.3VCONVERTER.8,VOUT(+), R12.2; also elsewhere on the board
+5V: 5VCONVERTER.7,SENSE+, 5VCONVERTER.8,VOUT(+), R11.2; also elsewhere on the board
+12V: 12VCONVERTER.7,SENSE+, 12VCONVERTER.8,VOUT(+), R10.2; also elsewhere on the board
AGND: 3.3VCONVERTER.3,VIN(-)/GND, 3.3VCONVERTER.4,VOUT(-)/GND, 3.3V_LED.C, 5VCONVERTER.3,VIN(-)/GND, 5VCONVERTER.4,VOUT(-)/GND, 5V_LED.C, 12VCONVERTER.3,VIN(-)/GND, 12VCONVERTER.4,VOUT(-)/GND, 12V_LED.C, C2.-, C7.-, C11.-, C12.-, Q7.2 (S), Q11.2 (S), Q12.2 (S), R2.1, R4.1, R5.1, R6.1, R7.1, R9.1; also elsewhere on the board
unnamed: 12VCONVERTER.6,TRIM, R5.2
unnamed: 5VCONVERTER.6,TRIM, R4.2
unnamed: 3.3VCONVERTER.6,TRIM, R6.2
unnamed: 3.3VCONVERTER.2,ON/OFF, Q12.3 (D)
unnamed: 12V_LED.A, R10.1
unnamed: 5V_LED.A, R11.1
unnamed: 3.3V_LED.A, R12.1
unnamed: 12VCONVERTER.2,ON/OFF, Q7.3 (D)
unnamed: 5VCONVERTER.2,ON/OFF, Q11.3 (D)
V+: C11.+, L1.1, L2.1, L3.1, R1.2, R3.2, R8.2; also elsewhere on the board

Notes on the sheet:
C:/Users/blain/Downloads/Black and White.bmp
Underwater Robotics Team Ohio State University
Converters

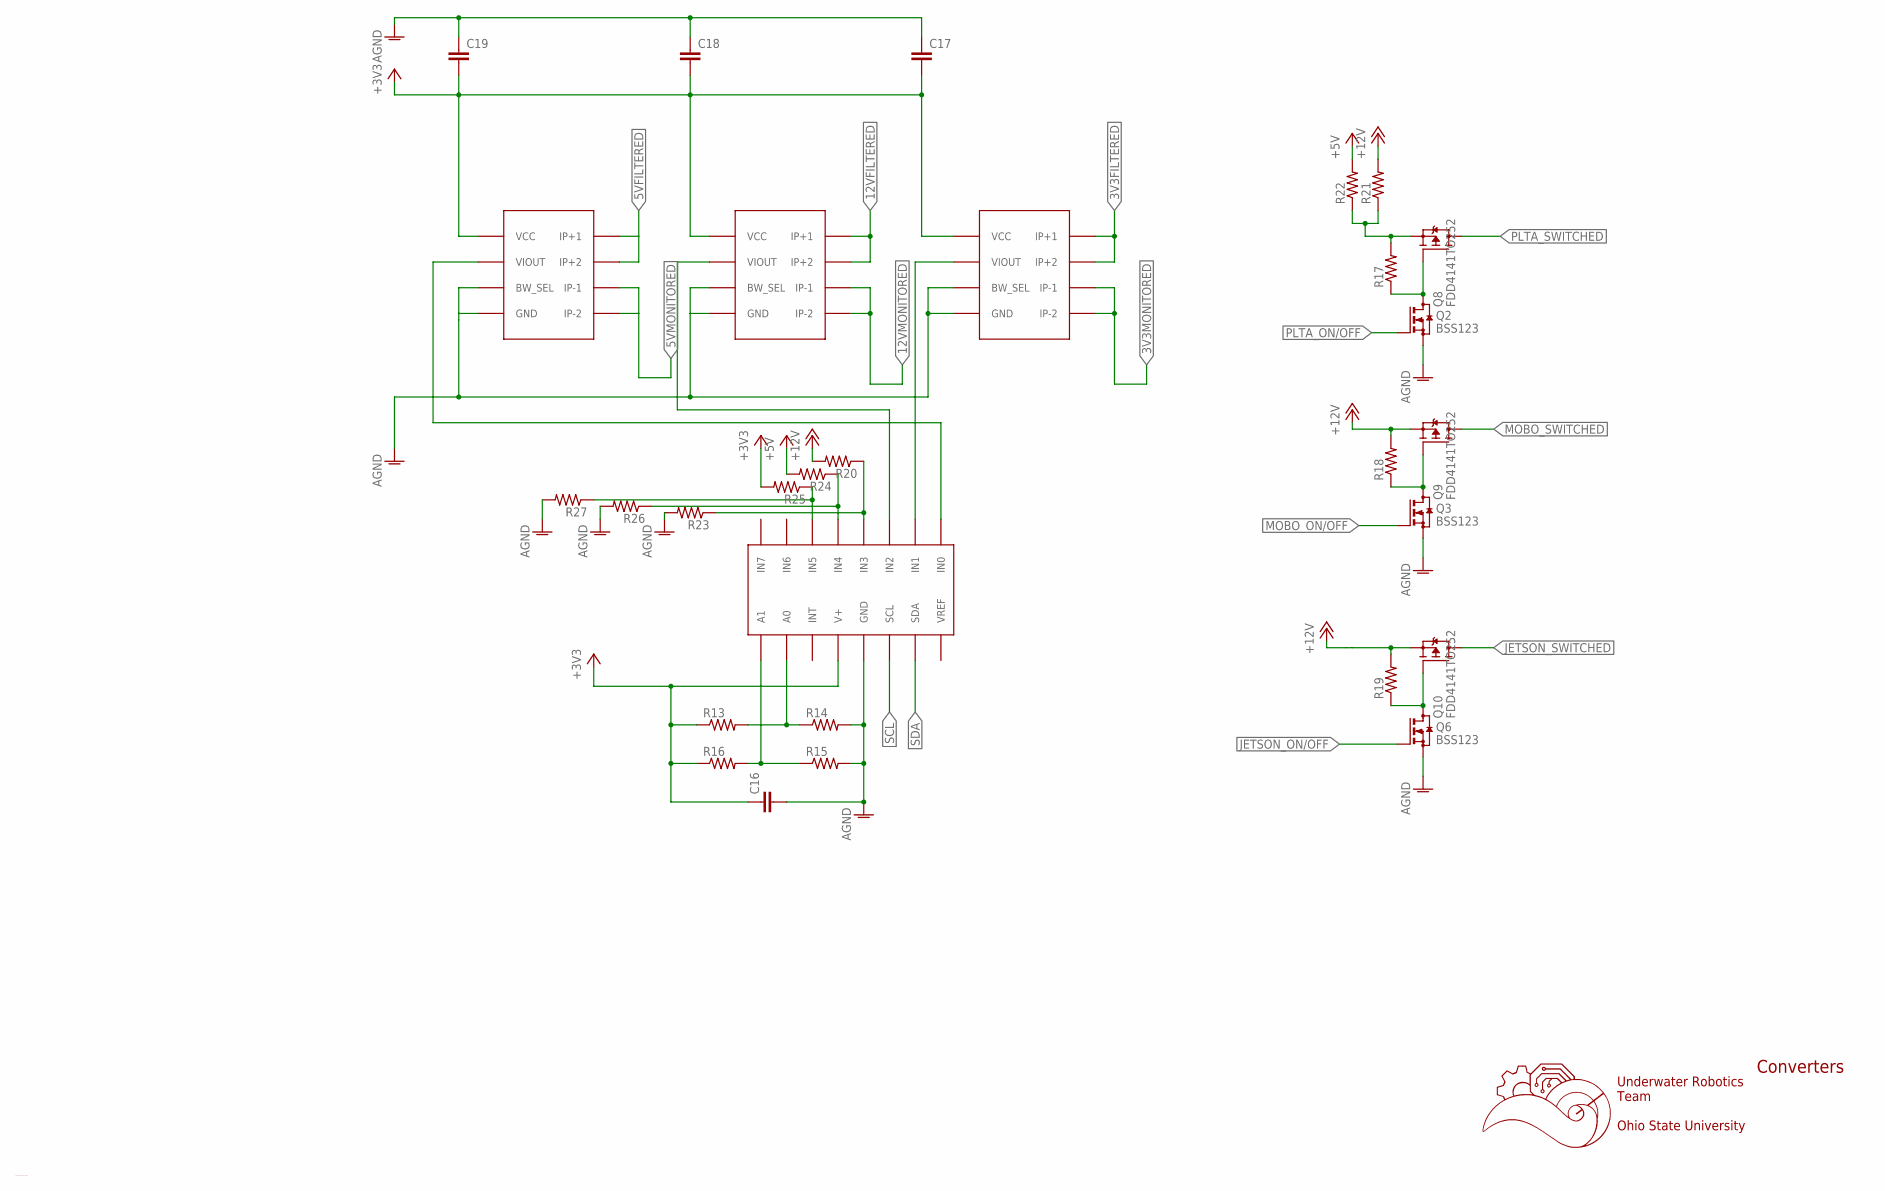
[picture p21: schematic Converter.sch, sheet 3]

Parts:
1C, 1C1, 1C2: ACS722; SOIC-8
C16, C17, C18, C19: C-EUC0603; C0603
Q2, Q3, Q6: BSS123; SOT23
Q8, Q9, Q10: FDD4141TO252; TO252
R13, R14, R15, R16, R17, R18, R19, R20, R23, R24, R25, R26, R27: R-US_R0603; R0603
R21, R22: R-US_M2309; M2309
U$2: ADC128D818; TSSOP-16

Connections:
3V3FILTERED: 1C2.IP+1, 1C2.IP+2; also elsewhere on the board
3V3MONITORED: 1C2.IP-1, 1C2.IP-2; also elsewhere on the board
5VFILTERED: 1C.IP+1, 1C.IP+2; also elsewhere on the board
5VMONITORED: 1C.IP-1, 1C.IP-2; also elsewhere on the board
12VFILTERED: 1C1.IP+1, 1C1.IP+2; also elsewhere on the board
12VMONITORED: 1C1.IP-1, 1C1.IP-2; also elsewhere on the board
+3V3: 1C.VCC, 1C1.VCC, 1C2.VCC, C16.1, C17.2, C18.2, C19.2, R13.1, R16.1, R25.2, U$2.V+; also elsewhere on the board
+5V: R22.2, R24.2; also elsewhere on the board
+12V: Q9.2 (S), Q10.2 (S), R18.2, R19.2, R20.2, R21.2; also elsewhere on the board
AGND: 1C.BW_SEL, 1C.GND, 1C1.BW_SEL, 1C1.GND, 1C2.BW_SEL, 1C2.GND, C16.2, C17.1, C18.1, C19.1, Q2.2 (S), Q3.2 (S), Q6.2 (S), R14.2, R15.2, R23.2, R26.2, R27.2, U$2.GND; also elsewhere on the board
JETSON_ON/OFF: Q6.1 (G); also elsewhere on the board
JETSON_SWITCHED: Q10.3 (D); also elsewhere on the board
MOBO_ON/OFF: Q3.1 (G); also elsewhere on the board
MOBO_SWITCHED: Q9.3 (D); also elsewhere on the board
unnamed: Q2.3 (D), Q8.1 (G), R17.1
unnamed: Q3.3 (D), Q9.1 (G), R18.1
unnamed: Q8.2 (S), R17.2, R21.1, R22.1
unnamed: 1C.VIOUT, U$2.IN0
unnamed: 1C1.VIOUT, U$2.IN2
unnamed: 1C2.VIOUT, U$2.IN1
unnamed: Q6.3 (D), Q10.1 (G), R19.1
unnamed: R20.1, R23.1, U$2.IN3
unnamed: R24.1, R26.1, U$2.IN4
unnamed: R25.1, R27.1, U$2.IN5
unnamed: R13.2, R14.1, U$2.A0
unnamed: R15.1, R16.2, U$2.A1
PLTA_ON/OFF: Q2.1 (G); also elsewhere on the board
PLTA_SWITCHED: Q8.3 (D); also elsewhere on the board
SCL: U$2.SCL; also elsewhere on the board
SDA: U$2.SDA; also elsewhere on the board

Notes on the sheet:
C:/Users/blain/Downloads/Black and White.bmp
Underwater Robotics Team Ohio State University
Converters

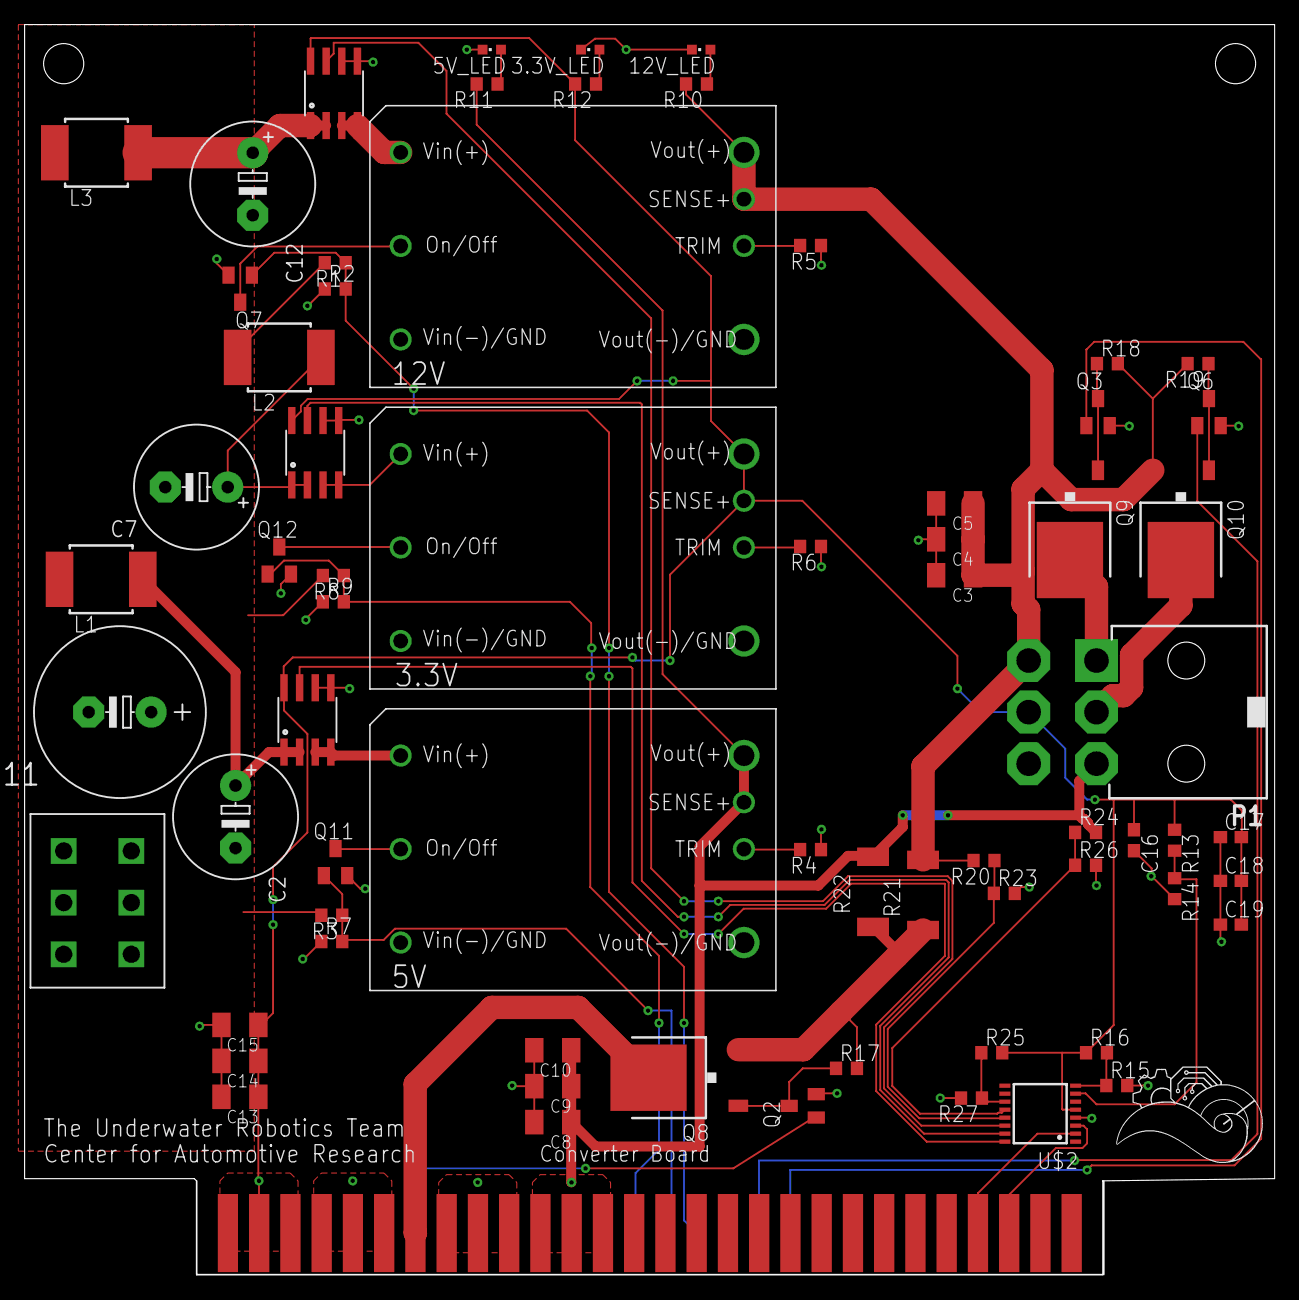
[picture p22: board Converter.brd from above]

Board: 2 copper layers, 101.6 x 101.6 mm, 69 parts (0 on the bottom side), 43 nets.
