SKhatri1029/uwrt_electronics/Maelstrom Boards/Acoustics/Acoustics.brd

## EAGLE design Maelstrom Boards/Acoustics/Acoustics.brd (2019-02-17)

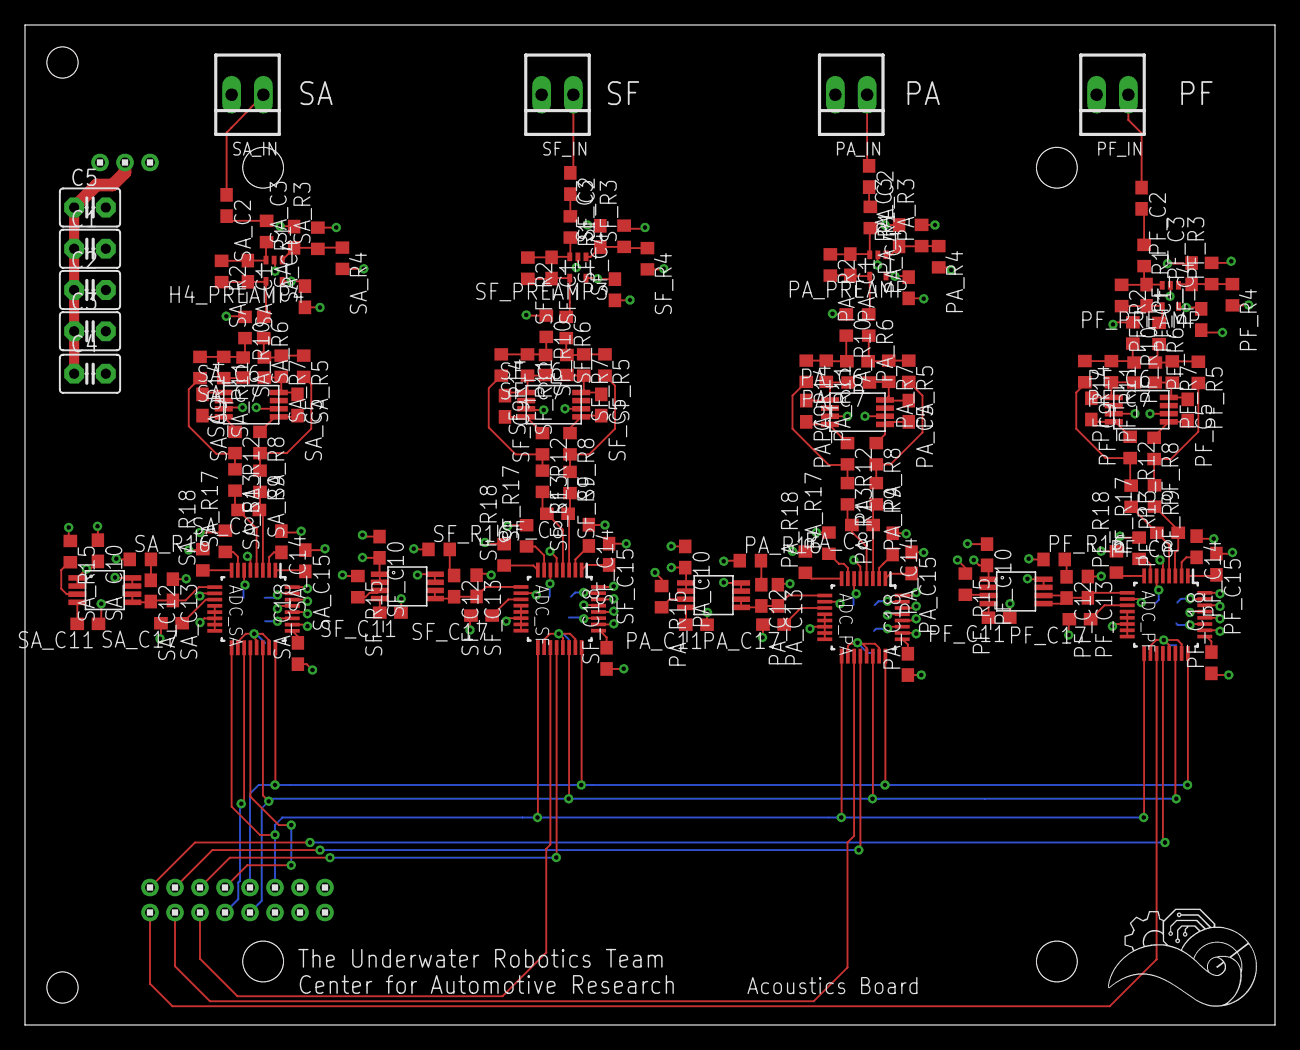
[picture p23: board Acoustics.brd from above]

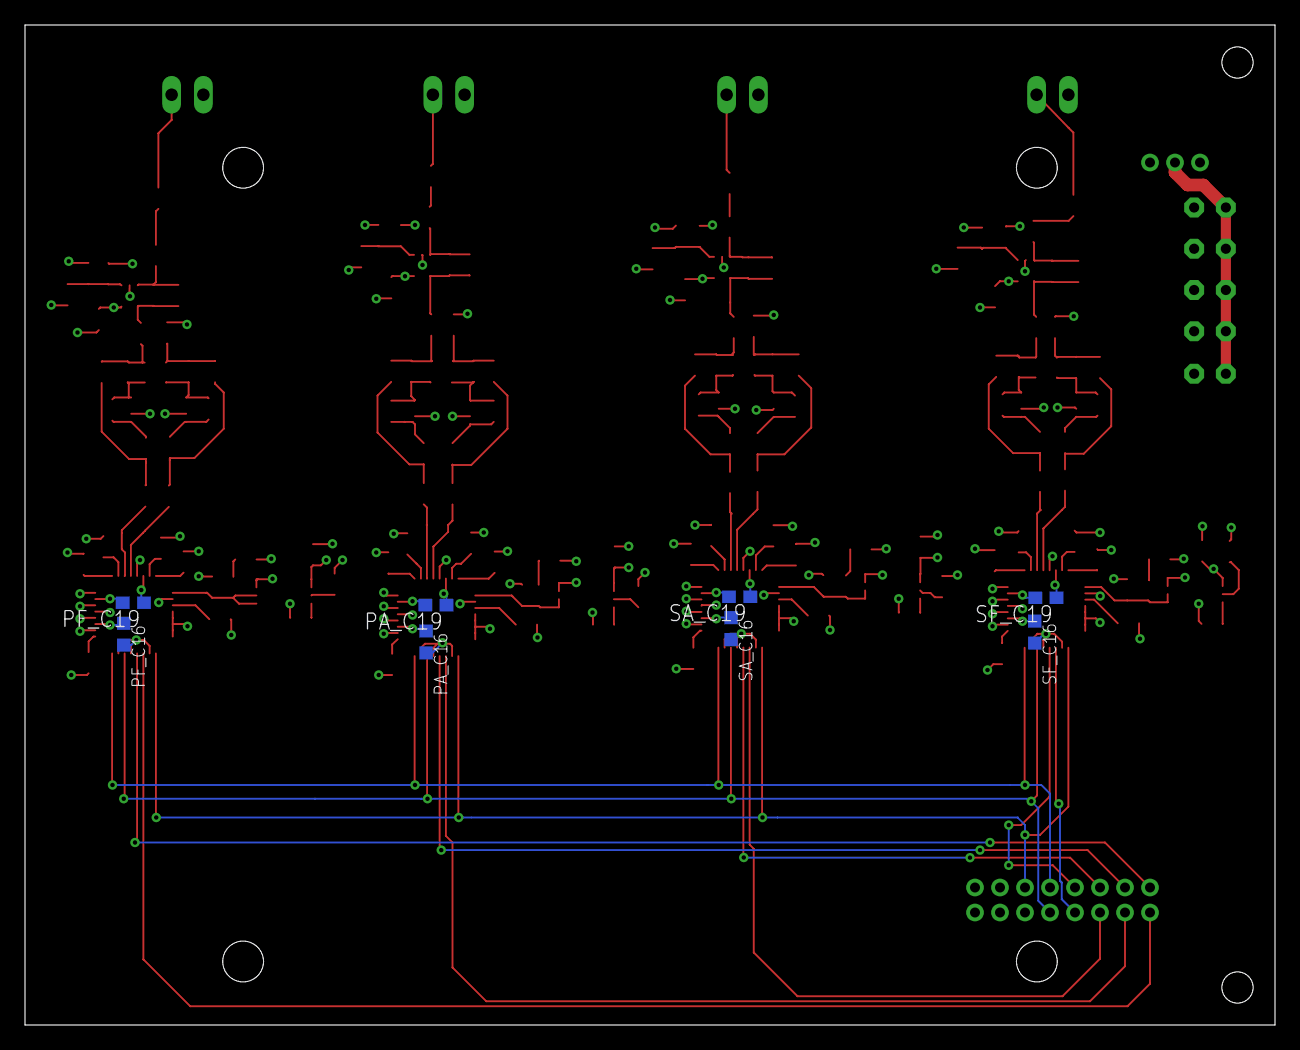
[picture p24: board Acoustics.brd from below]

Board: 4 copper layers, 100.0 x 80.0 mm, 175 parts (8 on the bottom side), 114 nets.

Parts:
ADC_PA: PBS0032A_L
ADC_PF: PBS0032A_L
ADC_SA: PBS0032A_L
ADC_SF: PBS0032A_L
C1, C2, C3, C4, C5: C2.5-3
FPGA_CON1: 2X8
FPGA_CON2: 1X3
H4_PREAMP4: TLV6741; SC70-5
PA_C1: 1pF; C0603
PA_C2: 5nF; C0603
PA_C3: 10uF; C0603
PA_C4: 100nF; C0603
PA_C5, PA_C9: 270pF; C0603
PA_C6: 470 pF; C0603
PA_C7: 1nF; C0603
PA_C8: 22nF; C0603
PA_C10: 10uf; C0603
PA_C11, PA_C14, PA_C15, PA_C17, PA_C18, PA_C19: 1uf; C0603
PA_C12: 47uf; C0603
PA_C13: 100nf; C0603
PA_C16: 1uf; C0603K
PA_DA: THS4551; VSSOP-8
PA_IN: 22-23-2021
PA_PREAMP: TLV6741; SC70-5
PA_R1: 10k; R0603
PA_R2: 1 M; R0603
PA_R3, PA_R4: 100k; R0603
PA_R5, PA_R10, PA_R14: 1.2k; R0603
PA_R6: 1.2K; R0603
PA_R7, PA_R11: 330; R0603
PA_R8, PA_R12: 5; R0603
PA_R9, PA_R13: 10; R0603
PA_R15: 121k; R0603
PA_R16: 47m; R0603
PA_R17: 60.4k; R0603
PA_R18: 10K; R0603
PA_REFGEN: REF6025
PF_C1: 1pF; C0603
PF_C2: 5nF; C0603
PF_C3: 10uF; C0603
PF_C4: 100nF; C0603
PF_C5, PF_C9: 270pF; C0603
PF_C6: 470 pF; C0603
PF_C7: 1nF; C0603
PF_C8: 22nF; C0603
PF_C10: 10uf; C0603
PF_C11, PF_C14, PF_C15, PF_C17, PF_C18, PF_C19: 1uf; C0603
PF_C12: 47uf; C0603
PF_C13: 100nf; C0603
PF_C16: 1uf; C0603K
PF_DA: THS4551; VSSOP-8
PF_IN: 22-23-2021
PF_PREAMP: TLV6741; SC70-5
PF_R1: 10k; R0603
PF_R2: 1 M; R0603
PF_R3, PF_R4: 100k; R0603
PF_R5, PF_R10, PF_R14: 1.2k; R0603
PF_R6: 1.2K; R0603
PF_R7, PF_R11: 330; R0603
PF_R8, PF_R12: 5; R0603
PF_R9, PF_R13: 10; R0603
PF_R15: 121k; R0603
PF_R16: 47m; R0603
PF_R17: 60.4k; R0603
PF_R18: 10K; R0603
PF_REFGEN: REF6025
SA_C1: 1pF; C0603
SA_C2: 5nF; C0603
SA_C3: 10uF; C0603
SA_C4: 100nF; C0603
SA_C5, SA_C9: 270pF; C0603
SA_C6: 470 pF; C0603
SA_C7: 1nF; C0603
SA_C8: 22nF; C0603
SA_C10: 10uf; C0603
SA_C11, SA_C14, SA_C15, SA_C17, SA_C18, SA_C19: 1uf; C0603
SA_C12: 47uf; C0603
SA_C13: 100nf; C0603
SA_C16: 1uf; C0603K
SA_DA: THS4551; VSSOP-8
SA_IN: 22-23-2021
SA_R1: 10k; R0603
SA_R2: 1 M; R0603
SA_R3, SA_R4: 100k; R0603
SA_R5, SA_R10, SA_R14: 1.2k; R0603
SA_R6: 1.2K; R0603
SA_R7, SA_R11: 330; R0603
SA_R8, SA_R12: 5; R0603
SA_R9, SA_R13: 10; R0603
SA_R15: 121k; R0603
SA_R16: 47m; R0603
SA_R17: 60.4k; R0603
SA_R18: 10K; R0603
SA_REFGEN: REF6025
SF_C1: 1pF; C0603
SF_C2: 5nF; C0603
SF_C3: 10uF; C0603
SF_C4: 100nF; C0603
SF_C5, SF_C9: 270pF; C0603
SF_C6: 470 pF; C0603
SF_C7: 1nF; C0603
SF_C8: 22nF; C0603
SF_C10: 10uf; C0603
SF_C11, SF_C14, SF_C15, SF_C17, SF_C18, SF_C19: 1uf; C0603
SF_C12: 47uf; C0603
SF_C13: 100nf; C0603
SF_C16: 1uf; C0603K
SF_DA: THS4551; VSSOP-8
SF_IN: 22-23-2021
SF_PREAMP3: TLV6741; SC70-5
SF_R1: 10k; R0603
SF_R2: 1 M; R0603
SF_R3, SF_R4: 100k; R0603
SF_R5, SF_R10, SF_R14: 1.2k; R0603
SF_R6: 1.2K; R0603
SF_R7, SF_R11: 330; R0603
SF_R8, SF_R12: 5; R0603
SF_R9, SF_R13: 10; R0603
SF_R15: 121k; R0603
SF_R16: 47m; R0603
SF_R17: 60.4k; R0603
SF_R18: 10K; R0603
SF_REFGEN: REF6025

Connections:
+3V3: ADC_PA.6, ADC_PA.27, ADC_PA.28, ADC_PA.29, ADC_PA.32, ADC_PF.6, ADC_PF.27, ADC_PF.28, ADC_PF.29, ADC_PF.32, ADC_SA.6, ADC_SA.27, ADC_SA.28, ADC_SA.29, ADC_SA.32, ADC_SF.6, ADC_SF.27, ADC_SF.28, ADC_SF.29, ADC_SF.32, FPGA_CON2.1, H4_PREAMP4.5, PA_C4.2, PA_C10.2, PA_C16.1, PA_C19.1, PA_DA.3, PA_PREAMP.5, PA_R4.2, PA_REFGEN.1, PA_REFGEN.2, PF_C4.2, PF_C10.2, PF_C16.1, PF_C19.1, PF_DA.3, PF_PREAMP.5, PF_R4.2, PF_REFGEN.1, PF_REFGEN.2, SA_C4.2, SA_C10.2, SA_C16.1, SA_C19.1, SA_DA.3, SA_R4.2, SA_REFGEN.1, SA_REFGEN.2, SF_C4.2, SF_C10.2, SF_C16.1, SF_C19.1, SF_DA.3, SF_PREAMP3.5, SF_R4.2, SF_REFGEN.1, SF_REFGEN.2
+5V: C1.1, C2.1, C3.1, C4.1, C5.1, FPGA_CON2.2
AMPED_PA: PA_C1.2, PA_PREAMP.4, PA_R2.2, PA_R6.1
AMPED_PF: PF_C1.2, PF_PREAMP.4, PF_R2.2, PF_R6.1
AMPED_SA: H4_PREAMP4.4, SA_C1.2, SA_R2.2, SA_R6.1
AMPED_SF: SF_C1.2, SF_PREAMP3.4, SF_R2.2, SF_R6.1
CLK: ADC_PA.24, ADC_PF.24, ADC_SA.24, ADC_SF.24, FPGA_CON1.10
DIFF_N_PA: ADC_PA.3, PA_C8.1, PA_R9.2
DIFF_N_PF: ADC_PF.3, PF_C8.1, PF_R9.2
DIFF_N_SA: ADC_SA.3, SA_C8.1, SA_R9.2
DIFF_N_SF: ADC_SF.3, SF_C8.1, SF_R9.2
DIFF_P_PA: ADC_PA.4, PA_C8.2, PA_R13.2
DIFF_P_PF: ADC_PF.4, PF_C8.2, PF_R13.2
DIFF_P_SA: ADC_SA.4, SA_C8.2, SA_R13.2
DIFF_P_SF: ADC_SF.4, SF_C8.2, SF_R13.2
DOUT_PA: ADC_PA.20, FPGA_CON1.4
DOUT_PF: ADC_PF.20, FPGA_CON1.2
DOUT_SA: ADC_SA.20, FPGA_CON1.8
DOUT_SF: ADC_SF.20, FPGA_CON1.6
DRDY_PA: ADC_PA.19, FPGA_CON1.3
DRDY_PF: ADC_PF.19, FPGA_CON1.1
DRDY_SA: ADC_SA.19, FPGA_CON1.7
DRDY_SF: ADC_SF.19, FPGA_CON1.5
GND: ADC_PA.5, ADC_PA.10, ADC_PA.12, ADC_PA.13, ADC_PA.14, ADC_PA.15, ADC_PA.16, ADC_PA.18, ADC_PA.21, ADC_PA.23, ADC_PA.26, ADC_PA.30, ADC_PA.31, ADC_PF.5, ADC_PF.10, ADC_PF.12, ADC_PF.13, ADC_PF.14, ADC_PF.15, ADC_PF.16, ADC_PF.18, ADC_PF.21, ADC_PF.23, ADC_PF.26, ADC_PF.30, ADC_PF.31, ADC_SA.5, ADC_SA.10, ADC_SA.12, ADC_SA.13, ADC_SA.14, ADC_SA.15, ADC_SA.16, ADC_SA.18, ADC_SA.21, ADC_SA.23, ADC_SA.26, ADC_SA.30, ADC_SA.31, ADC_SF.5, ADC_SF.10, ADC_SF.12, ADC_SF.13, ADC_SF.14, ADC_SF.15, ADC_SF.16, ADC_SF.18, ADC_SF.21, ADC_SF.23, ADC_SF.26, ADC_SF.30, ADC_SF.31, C1.2, C2.2, C3.2, C4.2, C5.2, FPGA_CON1.15, FPGA_CON1.16, FPGA_CON2.3, H4_PREAMP4.2, PA_C3.2, PA_C4.1, PA_C10.1, PA_C11.1, PA_C13.1, PA_C14.1, PA_C15.1, PA_C16.2, PA_C17.2, PA_C18.1, PA_C19.2, PA_DA.6, PA_IN.2, PA_PREAMP.2, PA_R3.2, PA_R10.1, PA_R15.1, PA_R16.1, PA_R17.2, PA_R18.2, PA_REFGEN.7, PA_REFGEN.8, PF_C3.2, PF_C4.1, PF_C10.1, PF_C11.1, PF_C13.1, PF_C14.1, PF_C15.1, PF_C16.2, PF_C17.2, PF_C18.1, PF_C19.2, PF_DA.6, PF_IN.2, PF_PREAMP.2, PF_R3.2, PF_R10.1, PF_R15.1, PF_R16.1, PF_R17.2, PF_R18.2, PF_REFGEN.7, PF_REFGEN.8, SA_C3.2, SA_C4.1, SA_C10.1, SA_C11.1, SA_C13.1, SA_C14.1, SA_C15.1, SA_C16.2, SA_C17.2, SA_C18.1, SA_C19.2, SA_DA.6, SA_IN.2, SA_R3.2, SA_R10.1, SA_R15.1, SA_R16.1, SA_R17.2, SA_R18.2, SA_REFGEN.7, SA_REFGEN.8, SF_C3.2, SF_C4.1, SF_C10.1, SF_C11.1, SF_C13.1, SF_C14.1, SF_C15.1, SF_C16.2, SF_C17.2, SF_C18.1, SF_C19.2, SF_DA.6, SF_IN.2, SF_PREAMP3.2, SF_R3.2, SF_R10.1, SF_R15.1, SF_R16.1, SF_R17.2, SF_R18.2, SF_REFGEN.7, SF_REFGEN.8
unnamed: PA_C5.2, PA_DA.5, PA_R8.1
unnamed: PA_C5.1, PA_C7.1, PA_DA.8, PA_R7.2
unnamed: PA_C7.2, PA_C9.1, PA_DA.1, PA_R11.2
unnamed: PA_C6.1, PA_R5.1, PA_R6.2, PA_R7.1
unnamed: PA_C6.2, PA_R10.2, PA_R11.1, PA_R14.1
unnamed: PA_C9.2, PA_DA.4, PA_R12.1
unnamed: PA_R5.2, PA_R8.2, PA_R9.1
unnamed: PA_R12.2, PA_R13.1, PA_R14.2
unnamed: SF_C5.2, SF_DA.5, SF_R8.1
unnamed: SF_C5.1, SF_C7.1, SF_DA.8, SF_R7.2
unnamed: SF_C7.2, SF_C9.1, SF_DA.1, SF_R11.2
unnamed: SF_C6.1, SF_R5.1, SF_R6.2, SF_R7.1
unnamed: SF_C6.2, SF_R10.2, SF_R11.1, SF_R14.1
unnamed: SF_C9.2, SF_DA.4, SF_R12.1
unnamed: SF_R5.2, SF_R8.2, SF_R9.1
unnamed: SF_R12.2, SF_R13.1, SF_R14.2
unnamed: SA_C5.2, SA_DA.5, SA_R8.1
unnamed: SA_C5.1, SA_C7.1, SA_DA.8, SA_R7.2
unnamed: SA_C7.2, SA_C9.1, SA_DA.1, SA_R11.2
unnamed: SA_C6.1, SA_R5.1, SA_R6.2, SA_R7.1
unnamed: SA_C6.2, SA_R10.2, SA_R11.1, SA_R14.1
unnamed: SA_C9.2, SA_DA.4, SA_R12.1
unnamed: SA_R5.2, SA_R8.2, SA_R9.1
unnamed: SA_R12.2, SA_R13.1, SA_R14.2
unnamed: PF_R12.2, PF_R13.1, PF_R14.2
unnamed: PF_C5.2, PF_DA.5, PF_R8.1
unnamed: PF_C5.1, PF_C7.1, PF_DA.8, PF_R7.2
unnamed: PF_C7.2, PF_C9.1, PF_DA.1, PF_R11.2
unnamed: PF_C6.1, PF_R5.1, PF_R6.2, PF_R7.1
unnamed: PF_C6.2, PF_R10.2, PF_R11.1, PF_R14.1
unnamed: PF_C9.2, PF_DA.4, PF_R12.1
unnamed: PF_C11.2, PF_REFGEN.4
unnamed: PF_R15.2, PF_REFGEN.3
unnamed: PF_C12.1, PF_R16.2
unnamed: PF_R5.2, PF_R8.2, PF_R9.1
unnamed: PA_C11.2, PA_REFGEN.4
unnamed: PA_R15.2, PA_REFGEN.3
unnamed: PA_C12.1, PA_R16.2
unnamed: SF_C11.2, SF_REFGEN.4
unnamed: SF_R15.2, SF_REFGEN.3
unnamed: SF_C12.1, SF_R16.2
unnamed: SA_C11.2, SA_REFGEN.4
unnamed: SA_R15.2, SA_REFGEN.3
unnamed: SA_C12.1, SA_R16.2
unnamed: ADC_PF.2, PF_C14.2
unnamed: PF_C2.2, PF_R1.1
unnamed: PF_C1.1, PF_PREAMP.3, PF_R1.2, PF_R2.1
unnamed: PF_C3.1, PF_PREAMP.1, PF_R3.1, PF_R4.1
unnamed: ADC_PA.1, PA_C15.2
unnamed: PA_C2.2, PA_R1.1
unnamed: PA_C1.1, PA_PREAMP.3, PA_R1.2, PA_R2.1
unnamed: PA_C3.1, PA_PREAMP.1, PA_R3.1, PA_R4.1
unnamed: ADC_PA.8, PA_R18.1
unnamed: SF_C2.2, SF_R1.1
unnamed: SF_C1.1, SF_PREAMP3.3, SF_R1.2, SF_R2.1
unnamed: SF_C3.1, SF_PREAMP3.1, SF_R3.1, SF_R4.1
unnamed: ADC_PA.7, PA_R17.1
unnamed: SA_C2.2, SA_R1.1
unnamed: H4_PREAMP4.3, SA_C1.1, SA_R1.2, SA_R2.1
unnamed: H4_PREAMP4.1, SA_C3.1, SA_R3.1, SA_R4.1
unnamed: ADC_PA.11, PA_C17.1
unnamed: ADC_PA.25, PA_C18.2
unnamed: ADC_PF.1, PF_C15.2
unnamed: ADC_PA.2, PA_C14.2
unnamed: ADC_PF.8, PF_R18.1
unnamed: ADC_PF.7, PF_R17.1
unnamed: ADC_PF.11, PF_C17.1
unnamed: ADC_PF.25, PF_C18.2
unnamed: ADC_SF.1, SF_C15.2
unnamed: ADC_SF.8, SF_R18.1
unnamed: ADC_SF.7, SF_R17.1
unnamed: ADC_SF.11, SF_C17.1
unnamed: ADC_SF.25, SF_C18.2
unnamed: ADC_SF.2, SF_C14.2
unnamed: ADC_SA.1, SA_C15.2
unnamed: ADC_SA.8, SA_R18.1
unnamed: ADC_SA.7, SA_R17.1
unnamed: ADC_SA.11, SA_C17.1
unnamed: ADC_SA.25, SA_C18.2
unnamed: ADC_SA.2, SA_C14.2
RAW_PA: PA_C2.1, PA_IN.1
RAW_PF: PF_C2.1, PF_IN.1
RAW_SA: SA_C2.1, SA_IN.1
RAW_SF: SF_C2.1, SF_IN.1
REF_PA: ADC_PA.9, PA_C12.2, PA_C13.2, PA_REFGEN.5, PA_REFGEN.6
REF_PF: ADC_PF.9, PF_C12.2, PF_C13.2, PF_REFGEN.5, PF_REFGEN.6
REF_SA: ADC_SA.9, SA_C12.2, SA_C13.2, SA_REFGEN.5, SA_REFGEN.6
REF_SF: ADC_SF.9, SF_C12.2, SF_C13.2, SF_REFGEN.5, SF_REFGEN.6
SCLK: ADC_PA.22, ADC_PF.22, ADC_SA.22, ADC_SF.22, FPGA_CON1.9
START: ADC_PA.17, ADC_PF.17, ADC_SA.17, ADC_SF.17, FPGA_CON1.12
