SKhatri1029/uwrt_electronics/(commit log)

2019-02-03 Began routing on converter board
    [Converter.brd, Converter.sch]
2019-02-17 Converter board completed
    [Converter.brd, Converter.sch]
